Killerbee12/TFM-UPM/Prueba1/prueba_v1.0.runs/impl_1/.init_design.begin.rst

<?xml version="1.0"?>
<ProcessHandle Version="1" Minor="0">
    <Process Command=".planAhead." Owner="kille" Host="PC-DE-POCHECHE" Pid="14240">
    </Process>
</ProcessHandle>
