Killerbee12/TFM-UPM/Practica/Prueba1_demo_v2.1.1/Prueba1_demo_v2.1.1.runs/design_1_util_vector_logic_1_0_synth_1/.vivado.begin.rst

<?xml version="1.0"?>
<ProcessHandle Version="1" Minor="0">
    <Process Command="vivado.bat" Owner="kille" Host="SAMSUNG_BOOK_3" Pid="15120" HostCore="12" HostMemory="08257945600">
    </Process>
</ProcessHandle>
