Killerbee12/TFM-UPM/Practica/Prueba1_demo_v2.1.1/Prueba1_demo_v2.1.1.runs/impl_1/.place_design.begin.rst

<?xml version="1.0"?>
<ProcessHandle Version="1" Minor="0">
    <Process Command=".planAhead." Owner="kille" Host="SAMSUNG_BOOK_3" Pid="23184">
    </Process>
</ProcessHandle>
