Killerbee12/TFM-UPM/Practica/Prueba1/prueba_v1.0.runs/design_1_top_system_0_1_synth_1/.vivado.begin.rst

<?xml version="1.0"?>
<ProcessHandle Version="1" Minor="0">
    <Process Command="vivado.bat" Owner="kille" Host="SAMSUNG_BOOK_3" Pid="19268" HostCore="12" HostMemory="08257945600">
    </Process>
</ProcessHandle>
