Killerbee12/TFM-UPM/Documentacion/Prototipo de Sonido y LEDs- V1.pptx

## LED & audio prototype - V1

HW and FW Definitions
FEB 2026

OSA Electronics Co., Ltd.

## Slide 2

Definición del Hardware V1

- MCU SILICON LABS SIWG917Y – WIFI 6 + BLE 5.4 – 8MB INTERNAL FLASH
- SPEAKER AMPLIFIER TAS2110 6.1W I2S
- DIGITAL MEMS MICROPHONE
- RGB LED RING WURTH ELEKTRONIK WL-ICLED
- 2X 18650 BATTERIES + BMS

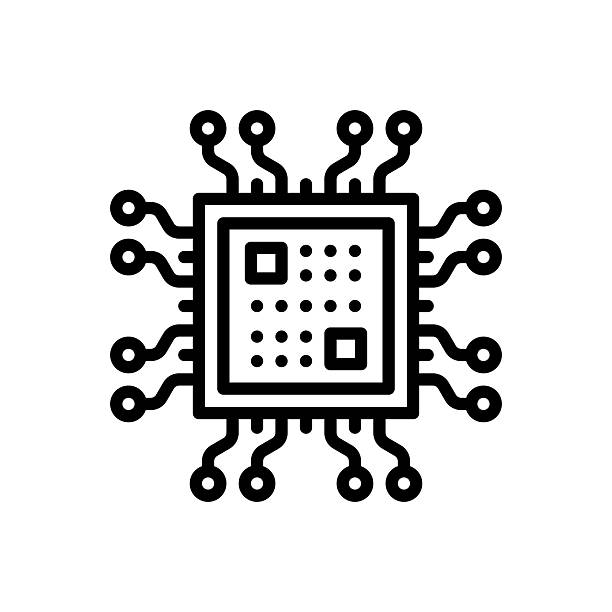
[picture p1: figure]

## Slide 3

Definición del Hardware V1

## Slide 4

Resources

- https://github.com/SiliconLabs/wiseconnect/tree/master/examples/si91x_soc/siwx917_dev_kit
- https://www.we-online.com/en/components/products/WL-ICLED#/articles/WL_ICLED_CHIP_LED_2020
- TAS (https://www.ti.com/lit/ds/symlink/tas2110.pdf?ts=1766407887314) 2110 (https://www.ti.com/lit/ds/symlink/tas2110.pdf?ts=1766407887314)Datasheet (https://www.ti.com/lit/ds/symlink/tas2110.pdf?ts=1766407887314)
- Simplicity Studio (https://www.silabs.com/developers/simplicity-studio)
- Simplicity Connect App (formerly EFR Connect App) (https://www.silabs.com/developers/simplicity-connect-mobile-app?tab=downloads)
