Killerbee12/TFM-UPM/Documentacion/Sondas_osciloscopio_P6100 passive probes.pdf

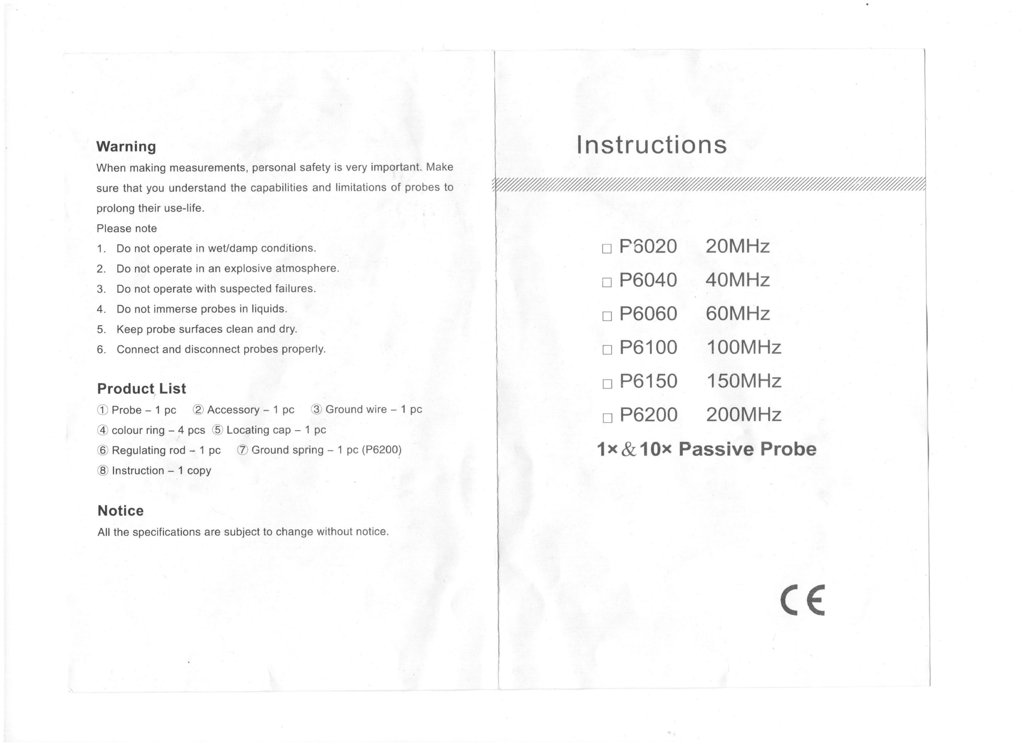
[picture p2: page 1]
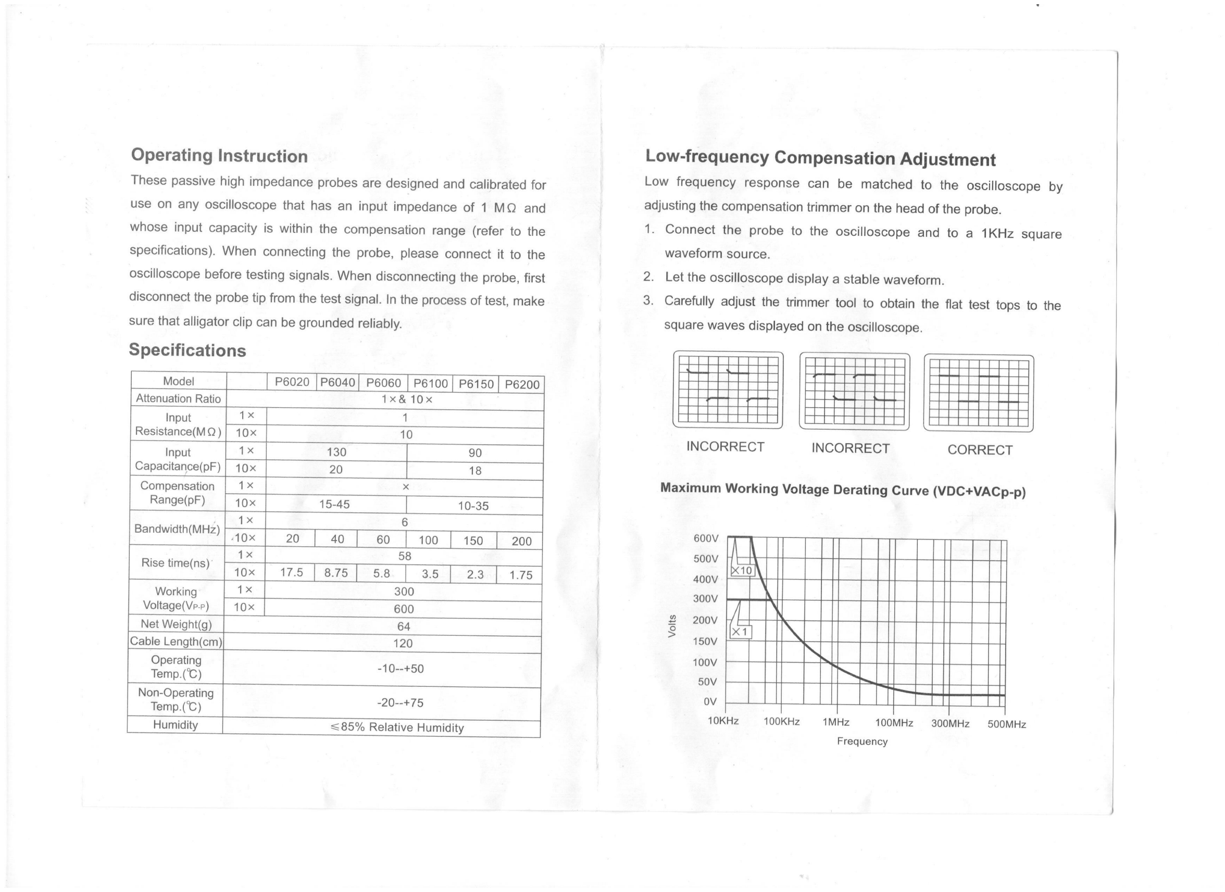
[picture p3: page 2]
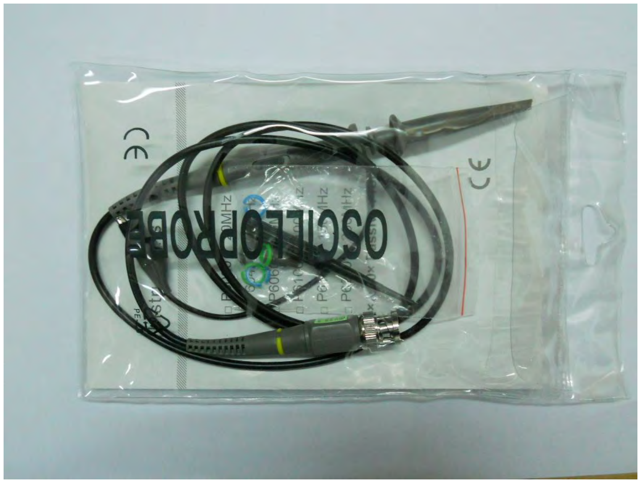
[picture p4: page 3]
