Killerbee12/TFM-UPM/Practica/Prueba1/prueba_v1.0.runs/impl_1/tight_setup_hold_pins.txt

+===============================+===============================+===================================================================================================================================================================================================================================================================================================================================================+
| Launch Setup Clock            | Launch Hold Clock             | Pin                                                                                                                                                                                                                                                                                                                                               |
+===============================+===============================+===================================================================================================================================================================================================================================================================================================================================================+
| clk_out1_design_1_clk_wiz_0_0 | clk_out1_design_1_clk_wiz_0_0 | design_1_i/top_system_0/U0/inst_audio_player/lrclk_prev_reg/D                                                                                                                                                                                                                                                                                     |
| clk_out1_design_1_clk_wiz_0_0 | clk_out1_design_1_clk_wiz_0_0 | design_1_i/blk_mem_gen_0/U0/inst_blk_mem_gen/gnbram.gnativebmg.native_blk_mem_gen/valid.cstr/ramloop[79].ram.r/prim_init.ram/design_1_i/blk_mem_gen_0/U0/inst_blk_mem_gen/gnbram.gnativebmg.native_blk_mem_gen/valid.cstr/ramloop[79].ram.r/prim_init.ram/DEVICE_7SERIES.NO_BMM_INFO.SP.CASCADED_PRIM36.ram_B_cooolgate_en_gate_14_cooolDelFlop/D |
| clk_out1_design_1_clk_wiz_0_0 | clk_out1_design_1_clk_wiz_0_0 | design_1_i/top_system_0/U0/inst_audio_player/addr_cnt_reg[11]/CE                                                                                                                                                                                                                                                                                  |
| clk_out1_design_1_clk_wiz_0_0 | clk_out1_design_1_clk_wiz_0_0 | design_1_i/top_system_0/U0/inst_audio_player/addr_cnt_reg[11]_replica_7/CE                                                                                                                                                                                                                                                                        |
| clk_out1_design_1_clk_wiz_0_0 | clk_out1_design_1_clk_wiz_0_0 | design_1_i/top_system_0/U0/inst_audio_player/addr_cnt_reg[10]_replica_5/CE                                                                                                                                                                                                                                                                        |
| clk_out1_design_1_clk_wiz_0_0 | clk_out1_design_1_clk_wiz_0_0 | design_1_i/top_system_0/U0/inst_audio_player/addr_cnt_reg[10]/CE                                                                                                                                                                                                                                                                                  |
| clk_out1_design_1_clk_wiz_0_0 | clk_out1_design_1_clk_wiz_0_0 | design_1_i/top_system_0/U0/inst_audio_player/addr_cnt_reg[11]_replica_2/CE                                                                                                                                                                                                                                                                        |
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
| clk_out1_design_1_clk_wiz_0_0 | clk_out1_design_1_clk_wiz_0_0 | design_1_i/system_ila_1/U0/ila_lib/U0/ila_core_inst/u_trig/U_TM/N_DDR_MODE.G_NMU[3].U_M/allx_typeA_match_detection.ltlib_v1_0_3_allx_typeA_inst/probeDelay1_reg[0]/D                                                                                                                                                                              |
+-------------------------------+-------------------------------+---------------------------------------------------------------------------------------------------------------------------------------------------------------------------------------------------------------------------------------------------------------------------------------------------------------------------------------------------+
