Killerbee12/TFM-UPM/Prueba1/prueba_v1.0.runs/impl_1/.vivado.begin.rst

<?xml version="1.0"?>
<ProcessHandle Version="1" Minor="0">
    <Process Command="vivado.bat" Owner="kille" Host="PC-DE-POCHECHE" Pid="13600" HostCore="4" HostMemory="017041461248">
    </Process>
</ProcessHandle>
<?xml version="1.0"?>
<ProcessHandle Version="1" Minor="0">
    <Process Command="vivado.bat" Owner="kille" Host="PC-DE-POCHECHE" Pid="14152" HostCore="4" HostMemory="017041461248">
    </Process>
</ProcessHandle>
<?xml version="1.0"?>
<ProcessHandle Version="1" Minor="0">
    <Process Command="vivado.bat" Owner="kille" Host="PC-DE-POCHECHE" Pid="13316" HostCore="4" HostMemory="017041461248">
    </Process>
</ProcessHandle>
<?xml version="1.0"?>
<ProcessHandle Version="1" Minor="0">
    <Process Command="vivado.bat" Owner="kille" Host="PC-DE-POCHECHE" Pid="14308" HostCore="4" HostMemory="017041461248">
    </Process>
</ProcessHandle>
<?xml version="1.0"?>
<ProcessHandle Version="1" Minor="0">
    <Process Command="vivado.bat" Owner="kille" Host="PC-DE-POCHECHE" Pid="14112" HostCore="4" HostMemory="017041461248">
    </Process>
</ProcessHandle>
