Killerbee12/TFM-UPM/Prueba1/prueba_v1.0.runs/synth_1/.vivado.begin.rst

<?xml version="1.0"?>
<ProcessHandle Version="1" Minor="0">
    <Process Command="vivado.bat" Owner="kille" Host="PC-DE-POCHECHE" Pid="14224" HostCore="4" HostMemory="017041461248">
    </Process>
</ProcessHandle>
