Killerbee12/TFM-UPM/Practica/Prueba1_demo_v2.1.1/Prueba1_demo_v2.1.1.runs/impl_1/.vivado.begin.rst

<?xml version="1.0"?>
<ProcessHandle Version="1" Minor="0">
    <Process Command="vivado.bat" Owner="kille" Host="SAMSUNG_BOOK_3" Pid="10956" HostCore="12" HostMemory="08257945600">
    </Process>
</ProcessHandle>
<?xml version="1.0"?>
<ProcessHandle Version="1" Minor="0">
    <Process Command="vivado.bat" Owner="kille" Host="SAMSUNG_BOOK_3" Pid="20960" HostCore="12" HostMemory="08257945600">
    </Process>
</ProcessHandle>
