Killerbee12/TFM-UPM/Practica/Prueba1_demo_v2.1.1/Prueba1_demo_v2.1.1.runs/impl_1/clockInfo.txt

-------------------------------------
| Tool Version : Vivado v.2025.1
| Date         : Wed Nov 11 23:36:08 2026
| Host         : Samsung_Book_3
| Design       : design_1
| Device       : xc7a100t-csg324-1--
-------------------------------------

For more information on clockInfo.txt clock routing debug file see https://support.xilinx.com/s/article/000035660?language=en_US
