Killerbee12/TFM-UPM/Practica/Prueba1/.Xil/Vivado-24480-Samsung_Book_3/hw_ila_data_1/zip_work/waveform.csv

Sample in Buffer | Sample in Window | TRIGGER | design_1_i/system_ila_0/U0/probe0[0:0]
Radix - UNSIGNED | UNSIGNED | UNSIGNED | HEX
0 | 0 | 0 | 0
1 | 1 | 0 | 0
2 | 2 | 0 | 0
3 | 3 | 0 | 0
4 | 4 | 0 | 0
5 | 5 | 0 | 0
6 | 6 | 0 | 0
7 | 7 | 0 | 0
8 | 8 | 0 | 0
9 | 9 | 0 | 0
10 | 10 | 0 | 0
11 | 11 | 0 | 0
12 | 12 | 0 | 0
13 | 13 | 0 | 0
14 | 14 | 0 | 0
15 | 15 | 0 | 0
16 | 16 | 0 | 0
17 | 17 | 0 | 0
18 | 18 | 0 | 0
19 | 19 | 0 | 0
20 | 20 | 0 | 0
21 | 21 | 0 | 0
22 | 22 | 0 | 0
23 | 23 | 0 | 0
24 | 24 | 0 | 0
25 | 25 | 0 | 0
26 | 26 | 0 | 0
27 | 27 | 0 | 0
28 | 28 | 0 | 0
29 | 29 | 0 | 0
30 | 30 | 0 | 0
31 | 31 | 0 | 0
32 | 32 | 0 | 0
33 | 33 | 0 | 0
34 | 34 | 0 | 0
35 | 35 | 0 | 0
36 | 36 | 0 | 0
37 | 37 | 0 | 0
38 | 38 | 0 | 0
39 | 39 | 0 | 0
40 | 40 | 0 | 0
41 | 41 | 0 | 0
42 | 42 | 0 | 0
43 | 43 | 0 | 0
44 | 44 | 0 | 0
45 | 45 | 0 | 0
46 | 46 | 0 | 0
47 | 47 | 0 | 0
48 | 48 | 0 | 0
49 | 49 | 0 | 0
50 | 50 | 0 | 0
51 | 51 | 0 | 0
52 | 52 | 0 | 0
53 | 53 | 0 | 0
54 | 54 | 0 | 0
55 | 55 | 0 | 0
56 | 56 | 0 | 0
57 | 57 | 0 | 0
58 | 58 | 0 | 0
59 | 59 | 0 | 0
60 | 60 | 0 | 0
61 | 61 | 0 | 0
62 | 62 | 0 | 0
63 | 63 | 0 | 0
64 | 64 | 0 | 0
65 | 65 | 0 | 0
66 | 66 | 0 | 0
67 | 67 | 0 | 0
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
