Killerbee12/TFM-UPM/Practica/Prueba1_demo_v2.1/.Xil/Vivado-17636-Samsung_Book_3/hw_ila_data_2/zip_work/waveform.csv

Sample in Buffer | Sample in Window | TRIGGER | design_1_i/system_ila_1/U0/probe0[0:0] | design_1_i/system_ila_1/U0/probe1[0:0] | design_1_i/system_ila_1/U0/probe2[0:0] | design_1_i/system_ila_1/U0/probe3[0:0] | design_1_i/system_ila_1/U0/probe4[0:0]
Radix - UNSIGNED | UNSIGNED | UNSIGNED | HEX | HEX | HEX | HEX | HEX
0 | 0 | 0 | 1 | 1 | 0 | 0 | 0
1 | 1 | 0 | 1 | 1 | 0 | 0 | 0
2 | 2 | 0 | 1 | 1 | 0 | 0 | 0
3 | 3 | 0 | 1 | 1 | 0 | 0 | 0
4 | 4 | 0 | 1 | 1 | 0 | 0 | 0
5 | 5 | 0 | 1 | 1 | 0 | 0 | 0
6 | 6 | 0 | 1 | 1 | 0 | 0 | 0
7 | 7 | 0 | 1 | 1 | 0 | 0 | 0
8 | 8 | 0 | 1 | 1 | 0 | 0 | 0
9 | 9 | 0 | 1 | 1 | 0 | 0 | 0
10 | 10 | 0 | 1 | 1 | 0 | 0 | 0
11 | 11 | 0 | 1 | 1 | 0 | 0 | 0
12 | 12 | 0 | 1 | 1 | 0 | 0 | 0
13 | 13 | 0 | 1 | 1 | 0 | 0 | 0
14 | 14 | 0 | 1 | 1 | 0 | 0 | 0
15 | 15 | 0 | 1 | 1 | 0 | 0 | 0
16 | 16 | 0 | 1 | 1 | 0 | 0 | 0
17 | 17 | 0 | 1 | 1 | 0 | 0 | 0
18 | 18 | 0 | 1 | 1 | 0 | 0 | 0
19 | 19 | 0 | 1 | 1 | 0 | 0 | 0
20 | 20 | 0 | 1 | 1 | 0 | 0 | 0
21 | 21 | 0 | 1 | 1 | 0 | 0 | 0
22 | 22 | 0 | 1 | 1 | 0 | 0 | 0
23 | 23 | 0 | 1 | 1 | 0 | 0 | 0
24 | 24 | 0 | 1 | 1 | 0 | 0 | 0
25 | 25 | 0 | 1 | 1 | 0 | 0 | 0
26 | 26 | 0 | 1 | 1 | 0 | 0 | 0
27 | 27 | 0 | 1 | 1 | 0 | 0 | 0
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
