Killerbee12/TFM-UPM/Capturas-Osciloscopio/Prueba_1_I2C/prueba_400khz_drenador_abierto.bmp

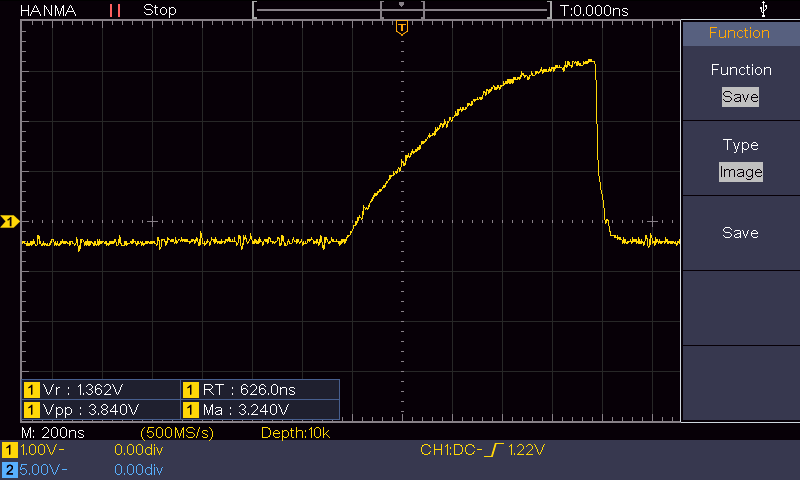
Capturas-Osciloscopio/Prueba_1_I2C/prueba_400khz_drenador_abierto.bmp
