Killerbee12/TFM-UPM/Capturas-Osciloscopio/Prueba_1_I2C/prueba_400khz_push_pull.bmp

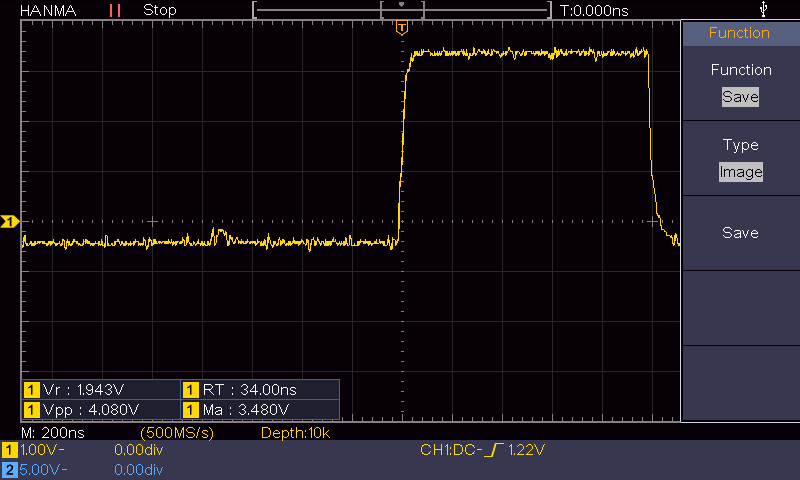
Capturas-Osciloscopio/Prueba_1_I2C/prueba_400khz_push_pull.bmp
