Killerbee12/TFM-UPM/Capturas-Osciloscopio/Prueba_1_I2C/secuencia_completa.bmp

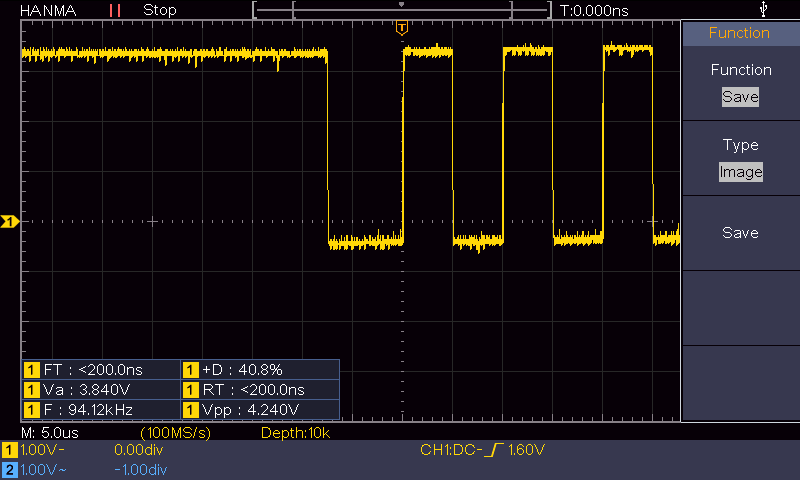
Capturas-Osciloscopio/Prueba_1_I2C/secuencia_completa.bmp
