Killerbee12/TFM-UPM/Capturas-Osciloscopio/Prueba_2_EtapaPotencia/bmp_26_006.bmp

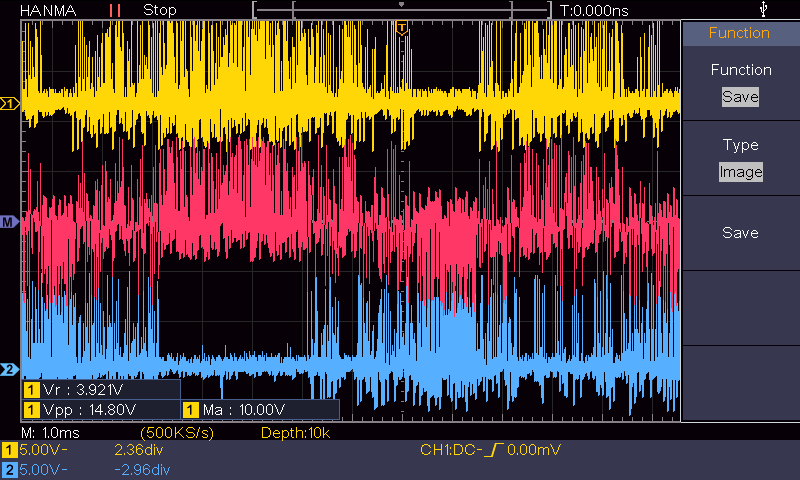
Capturas-Osciloscopio/Prueba_2_EtapaPotencia/bmp_26_006.bmp
