Killerbee12/TFM-UPM/Capturas-Osciloscopio/Prueba_2_EtapaPotencia/bmp_29_001.bmp

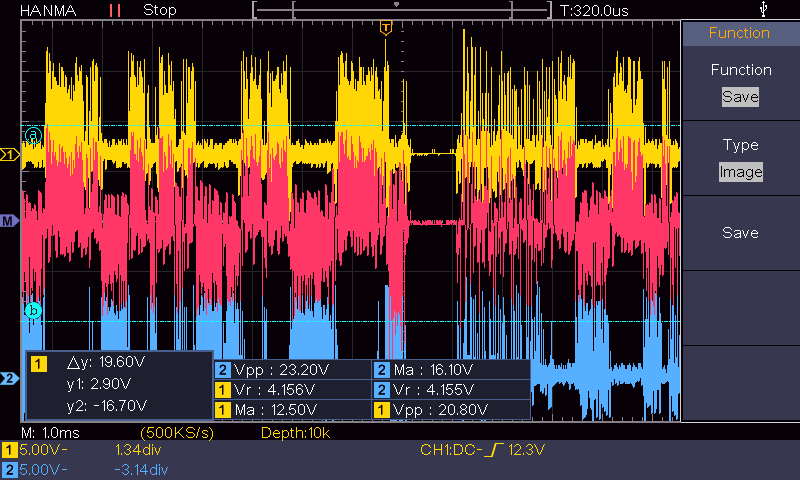
Capturas-Osciloscopio/Prueba_2_EtapaPotencia/bmp_29_001.bmp
