Killerbee12/TFM-UPM/Capturas-Osciloscopio/Prueba_2_EtapaPotencia/Con_limitador/A_01h_3_76Vpk.bmp

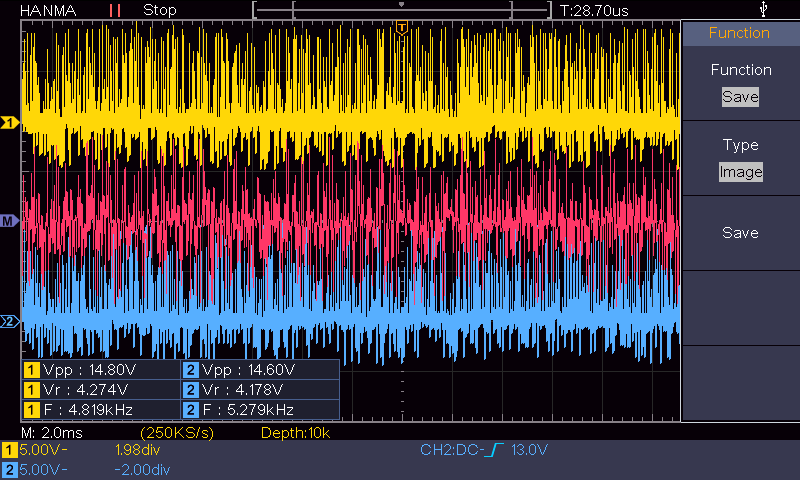
Capturas-Osciloscopio/Prueba_2_EtapaPotencia/Con_limitador/A_01h_3_76Vpk.bmp
