Killerbee12/TFM-UPM/Capturas-Osciloscopio/Prueba_2_EtapaPotencia/Con_limitador/bmp_32_011.bmp

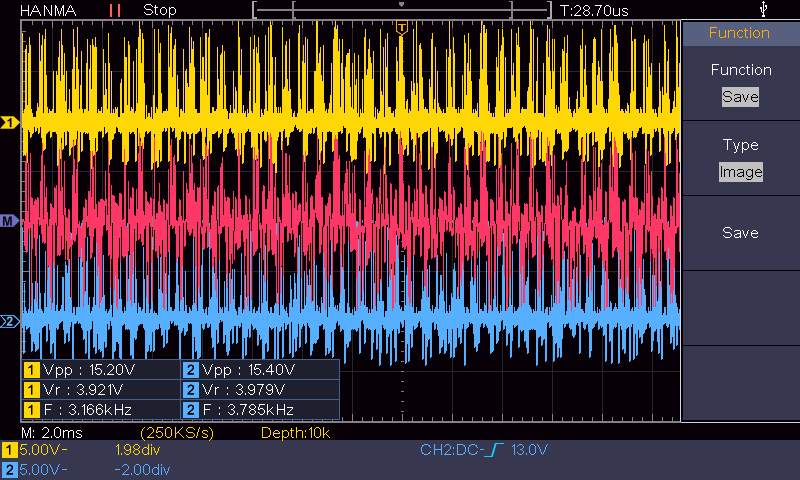
Capturas-Osciloscopio/Prueba_2_EtapaPotencia/Con_limitador/bmp_32_011.bmp
