Killerbee12/TFM-UPM/Capturas-Osciloscopio/Prueba_2_EtapaPotencia/Con_limitador/D_0Fh_8_43Vpk_1.bmp

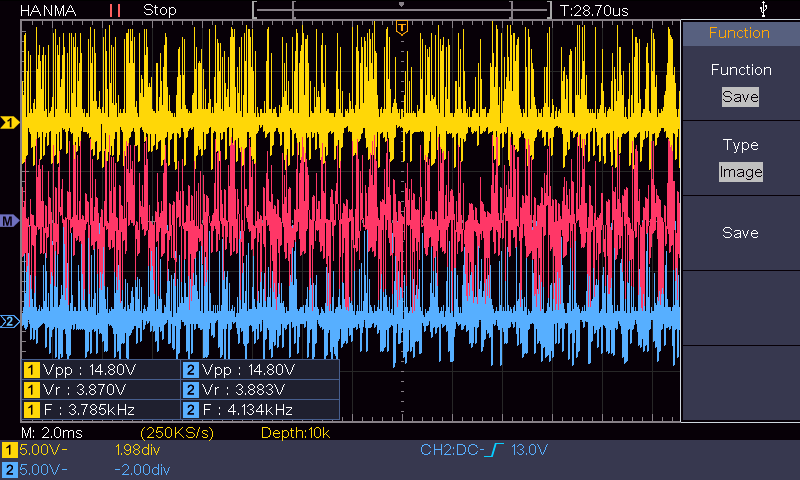
Capturas-Osciloscopio/Prueba_2_EtapaPotencia/Con_limitador/D_0Fh_8_43Vpk_1.bmp
