Killerbee12/TFM-UPM/Capturas-Osciloscopio/Prueba_2_EtapaPotencia/Con_limitador/E_14h_11_23Vpk_1.bmp

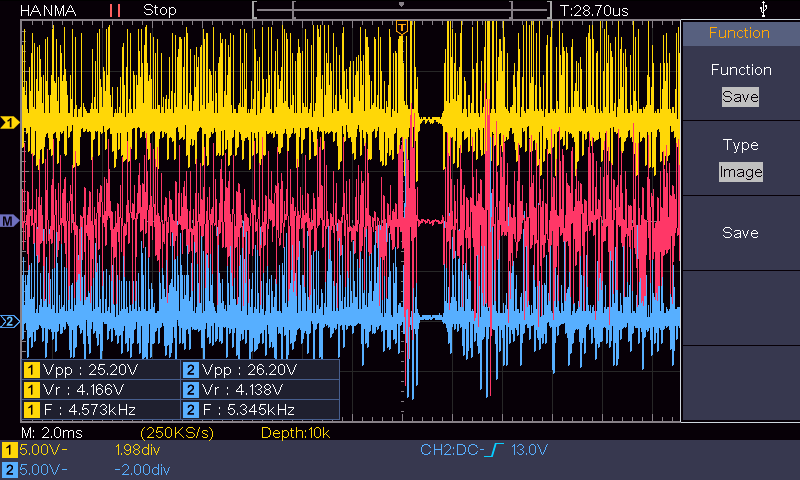
Capturas-Osciloscopio/Prueba_2_EtapaPotencia/Con_limitador/E_14h_11_23Vpk_1.bmp
