Killerbee12/TFM-UPM/Capturas-Osciloscopio/Prueba_2_EtapaPotencia/Sin_limitador/B_05h_4_74Vpk.bmp

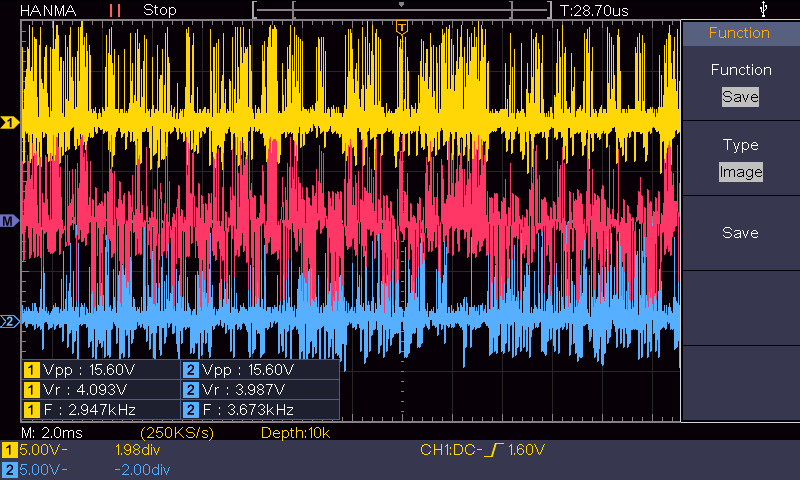
Capturas-Osciloscopio/Prueba_2_EtapaPotencia/Sin_limitador/B_05h_4_74Vpk.bmp
