Killerbee12/TFM-UPM/Capturas-Osciloscopio/Prueba_2_EtapaPotencia/Sin_limitador/bmp_32_005.bmp

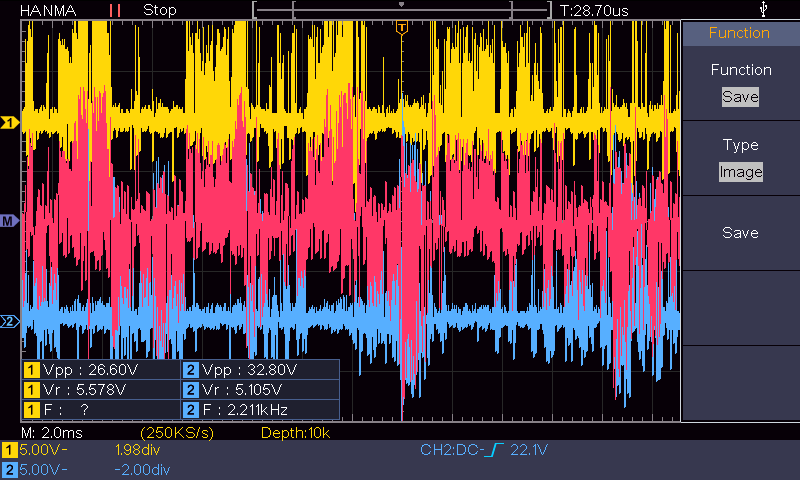
Capturas-Osciloscopio/Prueba_2_EtapaPotencia/Sin_limitador/bmp_32_005.bmp
