Killerbee12/TFM-UPM/Capturas-Osciloscopio/Prueba_2_EtapaPotencia/Sin_limitador/C_0Ah_6_32Vpk.bmp

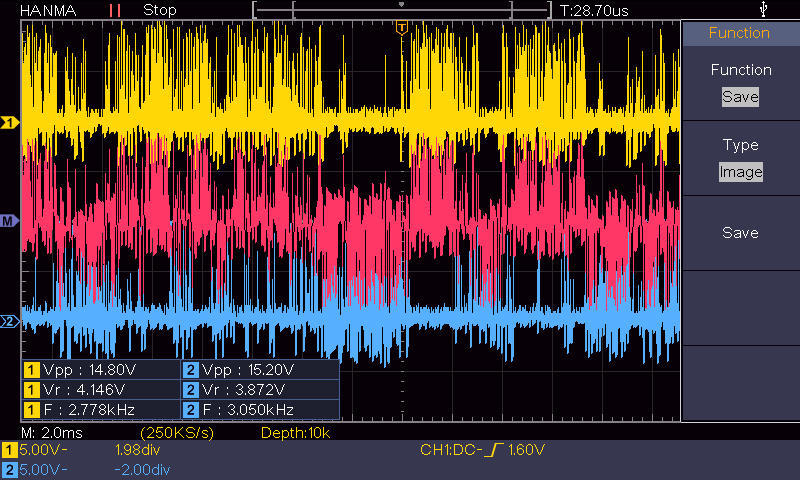
Capturas-Osciloscopio/Prueba_2_EtapaPotencia/Sin_limitador/C_0Ah_6_32Vpk.bmp
