Killerbee12/TFM-UPM/Capturas-Osciloscopio/Prueba_4_I2S_BCLK/bclk6.bmp

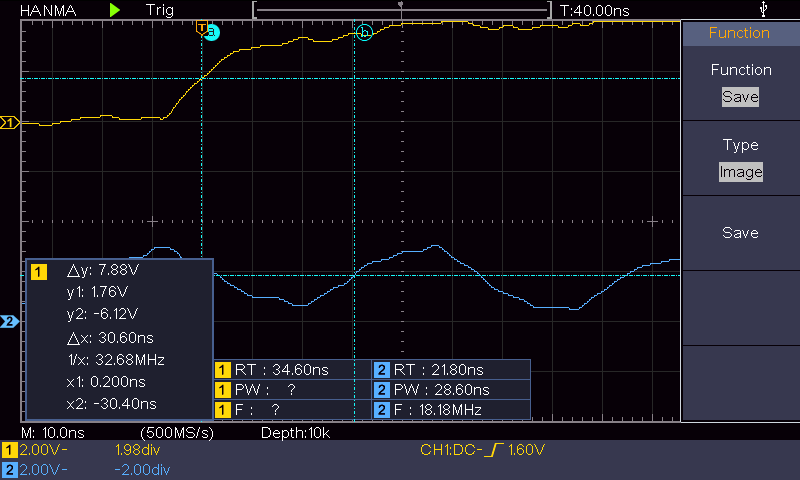
Capturas-Osciloscopio/Prueba_4_I2S_BCLK/bclk6.bmp
