Killerbee12/TFM-UPM/Documentacion/Esquematicos_Prototipo_FKR917XB_A0.pdf

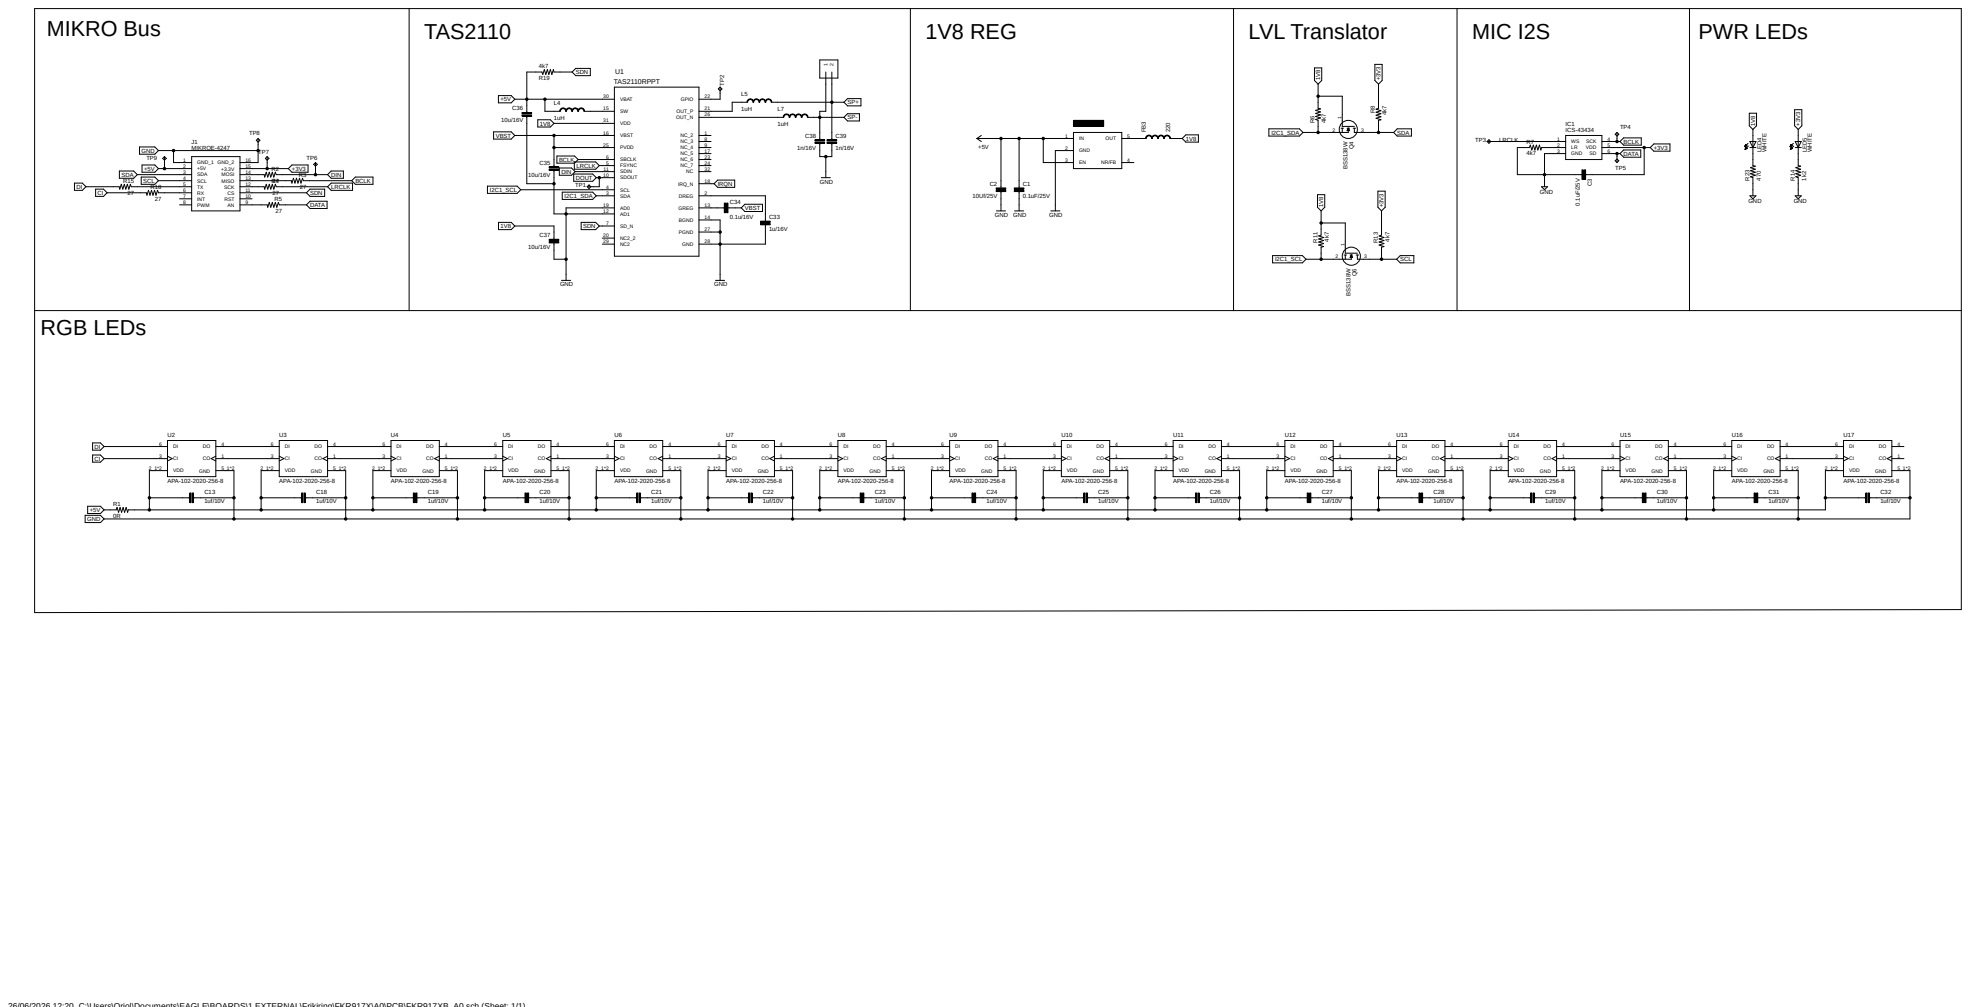
[picture p36: page 1]

26/06/2026 12:20 C:\Users\Oriol\Documents\EAGLE\BOARDS\1.EXTERNAL\Frikiring\FKR917X\A0\PCB\FKR917XB_A0.sch (Sheet: 1/1)
