Killerbee12/TFM-UPM/Practica/Prueba1/prueba_v1.0.runs/synth_1/.Xil/design_1_wrapper_propImpl.xdc

set_property SRC_FILE_INFO {cfile:C:/Users/kille/Documents/GitHub/TFM-UPM/Practica/Prueba1/prueba_v1.0.srcs/constrs_1/new/Nexys4DDR.xdc rfile:../../../prueba_v1.0.srcs/constrs_1/new/Nexys4DDR.xdc id:1} [current_design]
set_property src_info {type:XDC file:1 line:7 export:INPUT save:INPUT read:READ} [current_design]
set_property -dict { PACKAGE_PIN E3    IOSTANDARD LVCMOS33 } [get_ports { clk_100Mhz_0 }]; #IO_L12P_T1_MRCC_35 Sch=clk100mhz
set_property src_info {type:XDC file:1 line:50 export:INPUT save:INPUT read:READ} [current_design]
set_property -dict { PACKAGE_PIN T10   IOSTANDARD LVCMOS33 } [get_ports { seg_out_0_0[0] }]; #IO_L24N_T3_A00_D16_14 Sch=ca
set_property src_info {type:XDC file:1 line:51 export:INPUT save:INPUT read:READ} [current_design]
set_property -dict { PACKAGE_PIN R10   IOSTANDARD LVCMOS33 } [get_ports { seg_out_0_0[1] }]; #IO_25_14 Sch=cb
set_property src_info {type:XDC file:1 line:52 export:INPUT save:INPUT read:READ} [current_design]
set_property -dict { PACKAGE_PIN K16   IOSTANDARD LVCMOS33 } [get_ports { seg_out_0_0[2] }]; #IO_25_15 Sch=cc
set_property src_info {type:XDC file:1 line:53 export:INPUT save:INPUT read:READ} [current_design]
set_property -dict { PACKAGE_PIN K13   IOSTANDARD LVCMOS33 } [get_ports { seg_out_0_0[3] }]; #IO_L17P_T2_A26_15 Sch=cd
set_property src_info {type:XDC file:1 line:54 export:INPUT save:INPUT read:READ} [current_design]
set_property -dict { PACKAGE_PIN P15   IOSTANDARD LVCMOS33 } [get_ports { seg_out_0_0[4] }]; #IO_L13P_T2_MRCC_14 Sch=ce
set_property src_info {type:XDC file:1 line:55 export:INPUT save:INPUT read:READ} [current_design]
set_property -dict { PACKAGE_PIN T11   IOSTANDARD LVCMOS33 } [get_ports { seg_out_0_0[5] }]; #IO_L19P_T3_A10_D26_14 Sch=cf
set_property src_info {type:XDC file:1 line:56 export:INPUT save:INPUT read:READ} [current_design]
set_property -dict { PACKAGE_PIN L18   IOSTANDARD LVCMOS33 } [get_ports { seg_out_0_0[6] }]; #IO_L4P_T0_D04_14 Sch=cg
set_property src_info {type:XDC file:1 line:57 export:INPUT save:INPUT read:READ} [current_design]
set_property -dict { PACKAGE_PIN H15   IOSTANDARD LVCMOS33 } [get_ports { seg_dp_0_0 }]; #IO_L19N_T3_A21_VREF_15 Sch=dp
set_property src_info {type:XDC file:1 line:59 export:INPUT save:INPUT read:READ} [current_design]
set_property -dict { PACKAGE_PIN J17   IOSTANDARD LVCMOS33 } [get_ports { seg_an_0_0[0] }]; #IO_L23P_T3_FOE_B_15 Sch=an[0]
set_property src_info {type:XDC file:1 line:60 export:INPUT save:INPUT read:READ} [current_design]
set_property -dict { PACKAGE_PIN J18   IOSTANDARD LVCMOS33 } [get_ports { seg_an_0_0[1] }]; #IO_L23N_T3_FWE_B_15 Sch=an[1]
set_property src_info {type:XDC file:1 line:61 export:INPUT save:INPUT read:READ} [current_design]
set_property -dict { PACKAGE_PIN T9    IOSTANDARD LVCMOS33 } [get_ports { seg_an_0_0[2] }]; #IO_L24P_T3_A01_D17_14 Sch=an[2]
set_property src_info {type:XDC file:1 line:62 export:INPUT save:INPUT read:READ} [current_design]
set_property -dict { PACKAGE_PIN J14   IOSTANDARD LVCMOS33 } [get_ports { seg_an_0_0[3] }]; #IO_L19P_T3_A22_15 Sch=an[3]
set_property src_info {type:XDC file:1 line:63 export:INPUT save:INPUT read:READ} [current_design]
set_property -dict { PACKAGE_PIN P14   IOSTANDARD LVCMOS33 } [get_ports { seg_an_0_0[4] }]; #IO_L8N_T1_D12_14 Sch=an[4]
set_property src_info {type:XDC file:1 line:64 export:INPUT save:INPUT read:READ} [current_design]
set_property -dict { PACKAGE_PIN T14   IOSTANDARD LVCMOS33 } [get_ports { seg_an_0_0[5] }]; #IO_L14P_T2_SRCC_14 Sch=an[5]
set_property src_info {type:XDC file:1 line:65 export:INPUT save:INPUT read:READ} [current_design]
set_property -dict { PACKAGE_PIN K2    IOSTANDARD LVCMOS33 } [get_ports { seg_an_0_0[6] }]; #IO_L23P_T3_35 Sch=an[6]
set_property src_info {type:XDC file:1 line:66 export:INPUT save:INPUT read:READ} [current_design]
set_property -dict { PACKAGE_PIN U13   IOSTANDARD LVCMOS33 } [get_ports { seg_an_0_0[7] }]; #IO_L23N_T3_A02_D18_14 Sch=an[7]
set_property src_info {type:XDC file:1 line:70 export:INPUT save:INPUT read:READ} [current_design]
set_property -dict { PACKAGE_PIN J15   IOSTANDARD LVCMOS33 } [get_ports { sw0_reset_0 }]; #IO_L24N_T3_RS0_15 Sch=sw[0]
set_property src_info {type:XDC file:1 line:71 export:INPUT save:INPUT read:READ} [current_design]
set_property -dict { PACKAGE_PIN C12   IOSTANDARD LVCMOS33 } [get_ports { reset_n_0 }]; #IO_L3P_T0_DQS_AD1P_15 Sch=cpu_resetn
set_property src_info {type:XDC file:1 line:72 export:INPUT save:INPUT read:READ} [current_design]
set_property -dict { PACKAGE_PIN N17   IOSTANDARD LVCMOS33 } [get_ports { btn_center_0_0 }]; #IO_L9P_T1_DQS_14 Sch=btnc
set_property src_info {type:XDC file:1 line:73 export:INPUT save:INPUT read:READ} [current_design]
set_property -dict { PACKAGE_PIN M18   IOSTANDARD LVCMOS33 } [get_ports { btn_up_0_0 }]; #IO_L4N_T0_D05_14 Sch=btnu
set_property src_info {type:XDC file:1 line:74 export:INPUT save:INPUT read:READ} [current_design]
set_property -dict { PACKAGE_PIN P17   IOSTANDARD LVCMOS33 } [get_ports { btn_left_0_0 }]; #IO_L12P_T1_MRCC_14 Sch=btnl
set_property src_info {type:XDC file:1 line:75 export:INPUT save:INPUT read:READ} [current_design]
set_property -dict { PACKAGE_PIN M17   IOSTANDARD LVCMOS33 } [get_ports { btn_right_0_0 }]; #IO_L10N_T1_D15_14 Sch=btnr
set_property src_info {type:XDC file:1 line:76 export:INPUT save:INPUT read:READ} [current_design]
set_property -dict { PACKAGE_PIN P18   IOSTANDARD LVCMOS33 } [get_ports { btn_down_0_0 }]; #IO_L9N_T1_DQS_D13_14 Sch=btnd
set_property src_info {type:XDC file:1 line:81 export:INPUT save:INPUT read:READ} [current_design]
set_property -dict { PACKAGE_PIN C17   IOSTANDARD LVCMOS33 } [get_ports { led_clk_0 }]; #IO_L20N_T3_A19_15 Sch=ja[1]
set_property src_info {type:XDC file:1 line:82 export:INPUT save:INPUT read:READ} [current_design]
set_property -dict { PACKAGE_PIN D18   IOSTANDARD LVCMOS33 } [get_ports { led_data_0 }]; #IO_L21N_T3_DQS_A18_15 Sch=ja[2]
set_property src_info {type:XDC file:1 line:91 export:INPUT save:INPUT read:READ} [current_design]
set_property -dict { PACKAGE_PIN D14   IOSTANDARD LVCMOS33 PULLUP true } [get_ports { i2c_scl_0 }]; #IO_L1P_T0_AD0P_15 Sch=jb[1]
set_property src_info {type:XDC file:1 line:92 export:INPUT save:INPUT read:READ} [current_design]
set_property -dict { PACKAGE_PIN F16   IOSTANDARD LVCMOS33 PULLUP true } [get_ports { i2c_sda_0 }]; #IO_L14N_T2_SRCC_15 Sch=jb[2]
set_property src_info {type:XDC file:1 line:93 export:INPUT save:INPUT read:READ} [current_design]
set_property -dict { PACKAGE_PIN G16   IOSTANDARD LVCMOS33 } [get_ports { i2s_bclk_0 }]; #IO_L13N_T2_MRCC_15 Sch=jb[3]
set_property src_info {type:XDC file:1 line:94 export:INPUT save:INPUT read:READ} [current_design]
set_property -dict { PACKAGE_PIN H14   IOSTANDARD LVCMOS33 } [get_ports { i2s_lrclk_0 }]; #IO_L15P_T2_DQS_15 Sch=jb[4]
set_property src_info {type:XDC file:1 line:95 export:INPUT save:INPUT read:READ} [current_design]
set_property -dict { PACKAGE_PIN E16   IOSTANDARD LVCMOS33 } [get_ports { i2s_dout_0 }]; #IO_L11N_T1_SRCC_15 Sch=jb[7]
