Killerbee12/TFM-UPM/Practica/Prueba1_demo_v2.1.1/Prueba1_demo_v2.1.1.ip_user_files/bd/design_1/ip/design_1_fifo_generator_0_0/design_1_fifo_generator_0_0_sim_netlist.v

// Copyright 1986-2022 Xilinx, Inc. All Rights Reserved.
// Copyright 2022-2025 Advanced Micro Devices, Inc. All Rights Reserved.
// --------------------------------------------------------------------------------
// Tool Version: Vivado v.2025.1 (win64) Build 6140274 Thu May 22 00:12:29 MDT 2025
// Date        : Wed Aug  5 18:31:42 2026
// Host        : Samsung_Book_3 running 64-bit major release  (build 9200)
// Command     : write_verilog -force -mode funcsim -rename_top design_1_fifo_generator_0_0 -prefix
//               design_1_fifo_generator_0_0_ design_1_fifo_generator_0_0_sim_netlist.v
// Design      : design_1_fifo_generator_0_0
// Purpose     : This verilog netlist is a functional simulation representation of the design and should not be modified
//               or synthesized. This netlist cannot be used for SDF annotated simulation.
// Device      : xc7a100tcsg324-1
// --------------------------------------------------------------------------------
`timescale 1 ps / 1 ps

(* CHECK_LICENSE_TYPE = "design_1_fifo_generator_0_0,fifo_generator_v13_2_13,{}" *) (* downgradeipidentifiedwarnings = "yes" *) (* x_core_info = "fifo_generator_v13_2_13,Vivado 2025.1" *) 
(* NotValidForBitStream *)
module design_1_fifo_generator_0_0
   (clk,
    srst,
    din,
    wr_en,
    rd_en,
    dout,
    full,
    empty,
    valid,
    prog_full);
  (* x_interface_info = "xilinx.com:signal:clock:1.0 core_clk CLK" *) (* x_interface_mode = "slave core_clk" *) (* x_interface_parameter = "XIL_INTERFACENAME core_clk, FREQ_HZ 100000000, FREQ_TOLERANCE_HZ 0, PHASE 0.0, INSERT_VIP 0" *) input clk;
  input srst;
  (* x_interface_info = "xilinx.com:interface:fifo_write:1.0 FIFO_WRITE WR_DATA" *) (* x_interface_mode = "slave FIFO_WRITE" *) input [7:0]din;
  (* x_interface_info = "xilinx.com:interface:fifo_write:1.0 FIFO_WRITE WR_EN" *) input wr_en;
  (* x_interface_info = "xilinx.com:interface:fifo_read:1.0 FIFO_READ RD_EN" *) (* x_interface_mode = "slave FIFO_READ" *) input rd_en;
  (* x_interface_info = "xilinx.com:interface:fifo_read:1.0 FIFO_READ RD_DATA" *) output [7:0]dout;
  (* x_interface_info = "xilinx.com:interface:fifo_write:1.0 FIFO_WRITE FULL" *) output full;
  (* x_interface_info = "xilinx.com:interface:fifo_read:1.0 FIFO_READ EMPTY" *) output empty;
  output valid;
  output prog_full;

  wire clk;
  wire [7:0]din;
  wire [7:0]dout;
  wire empty;
  wire full;
  wire prog_full;
  wire rd_en;
  wire srst;
  wire valid;
  wire wr_en;
  wire NLW_U0_almost_empty_UNCONNECTED;
  wire NLW_U0_almost_full_UNCONNECTED;
  wire NLW_U0_axi_ar_dbiterr_UNCONNECTED;
  wire NLW_U0_axi_ar_overflow_UNCONNECTED;
  wire NLW_U0_axi_ar_prog_empty_UNCONNECTED;
  wire NLW_U0_axi_ar_prog_full_UNCONNECTED;
  wire NLW_U0_axi_ar_sbiterr_UNCONNECTED;
  wire NLW_U0_axi_ar_underflow_UNCONNECTED;
  wire NLW_U0_axi_aw_dbiterr_UNCONNECTED;
  wire NLW_U0_axi_aw_overflow_UNCONNECTED;
  wire NLW_U0_axi_aw_prog_empty_UNCONNECTED;
  wire NLW_U0_axi_aw_prog_full_UNCONNECTED;
  wire NLW_U0_axi_aw_sbiterr_UNCONNECTED;
  wire NLW_U0_axi_aw_underflow_UNCONNECTED;
  wire NLW_U0_axi_b_dbiterr_UNCONNECTED;
  wire NLW_U0_axi_b_overflow_UNCONNECTED;
  wire NLW_U0_axi_b_prog_empty_UNCONNECTED;
  wire NLW_U0_axi_b_prog_full_UNCONNECTED;
  wire NLW_U0_axi_b_sbiterr_UNCONNECTED;
  wire NLW_U0_axi_b_underflow_UNCONNECTED;
  wire NLW_U0_axi_r_dbiterr_UNCONNECTED;
  wire NLW_U0_axi_r_overflow_UNCONNECTED;
  wire NLW_U0_axi_r_prog_empty_UNCONNECTED;
  wire NLW_U0_axi_r_prog_full_UNCONNECTED;
  wire NLW_U0_axi_r_sbiterr_UNCONNECTED;
  wire NLW_U0_axi_r_underflow_UNCONNECTED;
  wire NLW_U0_axi_w_dbiterr_UNCONNECTED;
  wire NLW_U0_axi_w_overflow_UNCONNECTED;
  wire NLW_U0_axi_w_prog_empty_UNCONNECTED;
  wire NLW_U0_axi_w_prog_full_UNCONNECTED;
  wire NLW_U0_axi_w_sbiterr_UNCONNECTED;
  wire NLW_U0_axi_w_underflow_UNCONNECTED;
  wire NLW_U0_axis_dbiterr_UNCONNECTED;
  wire NLW_U0_axis_overflow_UNCONNECTED;
  wire NLW_U0_axis_prog_empty_UNCONNECTED;
  wire NLW_U0_axis_prog_full_UNCONNECTED;
  wire NLW_U0_axis_sbiterr_UNCONNECTED;
  wire NLW_U0_axis_underflow_UNCONNECTED;
  wire NLW_U0_dbiterr_UNCONNECTED;
  wire NLW_U0_m_axi_arvalid_UNCONNECTED;
  wire NLW_U0_m_axi_awvalid_UNCONNECTED;
  wire NLW_U0_m_axi_bready_UNCONNECTED;
  wire NLW_U0_m_axi_rready_UNCONNECTED;
  wire NLW_U0_m_axi_wlast_UNCONNECTED;
  wire NLW_U0_m_axi_wvalid_UNCONNECTED;
  wire NLW_U0_m_axis_tlast_UNCONNECTED;
  wire NLW_U0_m_axis_tvalid_UNCONNECTED;
  wire NLW_U0_overflow_UNCONNECTED;
  wire NLW_U0_prog_empty_UNCONNECTED;
  wire NLW_U0_rd_rst_busy_UNCONNECTED;
  wire NLW_U0_s_axi_arready_UNCONNECTED;
  wire NLW_U0_s_axi_awready_UNCONNECTED;
  wire NLW_U0_s_axi_bvalid_UNCONNECTED;
  wire NLW_U0_s_axi_rlast_UNCONNECTED;
  wire NLW_U0_s_axi_rvalid_UNCONNECTED;
  wire NLW_U0_s_axi_wready_UNCONNECTED;
  wire NLW_U0_s_axis_tready_UNCONNECTED;
  wire NLW_U0_sbiterr_UNCONNECTED;
  wire NLW_U0_underflow_UNCONNECTED;
  wire NLW_U0_wr_ack_UNCONNECTED;
  wire NLW_U0_wr_rst_busy_UNCONNECTED;
  wire [4:0]NLW_U0_axi_ar_data_count_UNCONNECTED;
  wire [4:0]NLW_U0_axi_ar_rd_data_count_UNCONNECTED;
  wire [4:0]NLW_U0_axi_ar_wr_data_count_UNCONNECTED;
  wire [4:0]NLW_U0_axi_aw_data_count_UNCONNECTED;
  wire [4:0]NLW_U0_axi_aw_rd_data_count_UNCONNECTED;
  wire [4:0]NLW_U0_axi_aw_wr_data_count_UNCONNECTED;
  wire [4:0]NLW_U0_axi_b_data_count_UNCONNECTED;
  wire [4:0]NLW_U0_axi_b_rd_data_count_UNCONNECTED;
  wire [4:0]NLW_U0_axi_b_wr_data_count_UNCONNECTED;
  wire [10:0]NLW_U0_axi_r_data_count_UNCONNECTED;
  wire [10:0]NLW_U0_axi_r_rd_data_count_UNCONNECTED;
  wire [10:0]NLW_U0_axi_r_wr_data_count_UNCONNECTED;
  wire [10:0]NLW_U0_axi_w_data_count_UNCONNECTED;
  wire [10:0]NLW_U0_axi_w_rd_data_count_UNCONNECTED;
  wire [10:0]NLW_U0_axi_w_wr_data_count_UNCONNECTED;
  wire [10:0]NLW_U0_axis_data_count_UNCONNECTED;
  wire [10:0]NLW_U0_axis_rd_data_count_UNCONNECTED;
  wire [10:0]NLW_U0_axis_wr_data_count_UNCONNECTED;
  wire [10:0]NLW_U0_data_count_UNCONNECTED;
  wire [31:0]NLW_U0_m_axi_araddr_UNCONNECTED;
  wire [1:0]NLW_U0_m_axi_arburst_UNCONNECTED;
  wire [3:0]NLW_U0_m_axi_arcache_UNCONNECTED;
  wire [0:0]NLW_U0_m_axi_arid_UNCONNECTED;
  wire [7:0]NLW_U0_m_axi_arlen_UNCONNECTED;
  wire [0:0]NLW_U0_m_axi_arlock_UNCONNECTED;
  wire [2:0]NLW_U0_m_axi_arprot_UNCONNECTED;
  wire [3:0]NLW_U0_m_axi_arqos_UNCONNECTED;
  wire [3:0]NLW_U0_m_axi_arregion_UNCONNECTED;
  wire [2:0]NLW_U0_m_axi_arsize_UNCONNECTED;
  wire [0:0]NLW_U0_m_axi_aruser_UNCONNECTED;
  wire [31:0]NLW_U0_m_axi_awaddr_UNCONNECTED;
  wire [1:0]NLW_U0_m_axi_awburst_UNCONNECTED;
  wire [3:0]NLW_U0_m_axi_awcache_UNCONNECTED;
  wire [0:0]NLW_U0_m_axi_awid_UNCONNECTED;
  wire [7:0]NLW_U0_m_axi_awlen_UNCONNECTED;
  wire [0:0]NLW_U0_m_axi_awlock_UNCONNECTED;
  wire [2:0]NLW_U0_m_axi_awprot_UNCONNECTED;
  wire [3:0]NLW_U0_m_axi_awqos_UNCONNECTED;
  wire [3:0]NLW_U0_m_axi_awregion_UNCONNECTED;
  wire [2:0]NLW_U0_m_axi_awsize_UNCONNECTED;
  wire [0:0]NLW_U0_m_axi_awuser_UNCONNECTED;
  wire [63:0]NLW_U0_m_axi_wdata_UNCONNECTED;
  wire [0:0]NLW_U0_m_axi_wid_UNCONNECTED;
  wire [7:0]NLW_U0_m_axi_wstrb_UNCONNECTED;
  wire [0:0]NLW_U0_m_axi_wuser_UNCONNECTED;
  wire [7:0]NLW_U0_m_axis_tdata_UNCONNECTED;
  wire [0:0]NLW_U0_m_axis_tdest_UNCONNECTED;
  wire [0:0]NLW_U0_m_axis_tid_UNCONNECTED;
  wire [0:0]NLW_U0_m_axis_tkeep_UNCONNECTED;
  wire [0:0]NLW_U0_m_axis_tstrb_UNCONNECTED;
  wire [3:0]NLW_U0_m_axis_tuser_UNCONNECTED;
  wire [10:0]NLW_U0_rd_data_count_UNCONNECTED;
  wire [0:0]NLW_U0_s_axi_bid_UNCONNECTED;
  wire [1:0]NLW_U0_s_axi_bresp_UNCONNECTED;
  wire [0:0]NLW_U0_s_axi_buser_UNCONNECTED;
  wire [63:0]NLW_U0_s_axi_rdata_UNCONNECTED;
  wire [0:0]NLW_U0_s_axi_rid_UNCONNECTED;
  wire [1:0]NLW_U0_s_axi_rresp_UNCONNECTED;
  wire [0:0]NLW_U0_s_axi_ruser_UNCONNECTED;
  wire [10:0]NLW_U0_wr_data_count_UNCONNECTED;

  (* C_ADD_NGC_CONSTRAINT = "0" *) 
  (* C_APPLICATION_TYPE_AXIS = "0" *) 
  (* C_APPLICATION_TYPE_RACH = "0" *) 
  (* C_APPLICATION_TYPE_RDCH = "0" *) 
  (* C_APPLICATION_TYPE_WACH = "0" *) 
  (* C_APPLICATION_TYPE_WDCH = "0" *) 
  (* C_APPLICATION_TYPE_WRCH = "0" *) 
  (* C_AXIS_TDATA_WIDTH = "8" *) 
  (* C_AXIS_TDEST_WIDTH = "1" *) 
  (* C_AXIS_TID_WIDTH = "1" *) 
  (* C_AXIS_TKEEP_WIDTH = "1" *) 
  (* C_AXIS_TSTRB_WIDTH = "1" *) 
  (* C_AXIS_TUSER_WIDTH = "4" *) 
  (* C_AXIS_TYPE = "0" *) 
  (* C_AXI_ADDR_WIDTH = "32" *) 
  (* C_AXI_ARUSER_WIDTH = "1" *) 
  (* C_AXI_AWUSER_WIDTH = "1" *) 
  (* C_AXI_BUSER_WIDTH = "1" *) 
  (* C_AXI_DATA_WIDTH = "64" *) 
  (* C_AXI_ID_WIDTH = "1" *) 
  (* C_AXI_LEN_WIDTH = "8" *) 
  (* C_AXI_LOCK_WIDTH = "1" *) 
  (* C_AXI_RUSER_WIDTH = "1" *) 
  (* C_AXI_TYPE = "1" *) 
  (* C_AXI_WUSER_WIDTH = "1" *) 
  (* C_COMMON_CLOCK = "1" *) 
  (* C_COUNT_TYPE = "0" *) 
  (* C_DATA_COUNT_WIDTH = "11" *) 
  (* C_DEFAULT_VALUE = "BlankString" *) 
  (* C_DIN_WIDTH = "8" *) 
  (* C_DIN_WIDTH_AXIS = "1" *) 
  (* C_DIN_WIDTH_RACH = "32" *) 
  (* C_DIN_WIDTH_RDCH = "64" *) 
  (* C_DIN_WIDTH_WACH = "1" *) 
  (* C_DIN_WIDTH_WDCH = "64" *) 
  (* C_DIN_WIDTH_WRCH = "2" *) 
  (* C_DOUT_RST_VAL = "0" *) 
  (* C_DOUT_WIDTH = "8" *) 
  (* C_ENABLE_RLOCS = "0" *) 
  (* C_ENABLE_RST_SYNC = "1" *) 
  (* C_EN_SAFETY_CKT = "0" *) 
  (* C_ERROR_INJECTION_TYPE = "0" *) 
  (* C_ERROR_INJECTION_TYPE_AXIS = "0" *) 
  (* C_ERROR_INJECTION_TYPE_RACH = "0" *) 
  (* C_ERROR_INJECTION_TYPE_RDCH = "0" *) 
  (* C_ERROR_INJECTION_TYPE_WACH = "0" *) 
  (* C_ERROR_INJECTION_TYPE_WDCH = "0" *) 
  (* C_ERROR_INJECTION_TYPE_WRCH = "0" *) 
  (* C_FAMILY = "artix7" *) 
  (* C_FULL_FLAGS_RST_VAL = "0" *) 
  (* C_HAS_ALMOST_EMPTY = "0" *) 
  (* C_HAS_ALMOST_FULL = "0" *) 
  (* C_HAS_AXIS_TDATA = "1" *) 
  (* C_HAS_AXIS_TDEST = "0" *) 
  (* C_HAS_AXIS_TID = "0" *) 
  (* C_HAS_AXIS_TKEEP = "0" *) 
  (* C_HAS_AXIS_TLAST = "0" *) 
  (* C_HAS_AXIS_TREADY = "1" *) 
  (* C_HAS_AXIS_TSTRB = "0" *) 
  (* C_HAS_AXIS_TUSER = "1" *) 
  (* C_HAS_AXI_ARUSER = "0" *) 
  (* C_HAS_AXI_AWUSER = "0" *) 
  (* C_HAS_AXI_BUSER = "0" *) 
  (* C_HAS_AXI_ID = "0" *) 
  (* C_HAS_AXI_RD_CHANNEL = "1" *) 
  (* C_HAS_AXI_RUSER = "0" *) 
  (* C_HAS_AXI_WR_CHANNEL = "1" *) 
  (* C_HAS_AXI_WUSER = "0" *) 
  (* C_HAS_BACKUP = "0" *) 
  (* C_HAS_DATA_COUNT = "0" *) 
  (* C_HAS_DATA_COUNTS_AXIS = "0" *) 
  (* C_HAS_DATA_COUNTS_RACH = "0" *) 
  (* C_HAS_DATA_COUNTS_RDCH = "0" *) 
  (* C_HAS_DATA_COUNTS_WACH = "0" *) 
  (* C_HAS_DATA_COUNTS_WDCH = "0" *) 
  (* C_HAS_DATA_COUNTS_WRCH = "0" *) 
  (* C_HAS_INT_CLK = "0" *) 
  (* C_HAS_MASTER_CE = "0" *) 
  (* C_HAS_MEMINIT_FILE = "0" *) 
  (* C_HAS_OVERFLOW = "0" *) 
  (* C_HAS_PROG_FLAGS_AXIS = "0" *) 
  (* C_HAS_PROG_FLAGS_RACH = "0" *) 
  (* C_HAS_PROG_FLAGS_RDCH = "0" *) 
  (* C_HAS_PROG_FLAGS_WACH = "0" *) 
  (* C_HAS_PROG_FLAGS_WDCH = "0" *) 
  (* C_HAS_PROG_FLAGS_WRCH = "0" *) 
  (* C_HAS_RD_DATA_COUNT = "0" *) 
  (* C_HAS_RD_RST = "0" *) 
  (* C_HAS_RST = "0" *) 
  (* C_HAS_SLAVE_CE = "0" *) 
  (* C_HAS_SRST = "1" *) 
  (* C_HAS_UNDERFLOW = "0" *) 
  (* C_HAS_VALID = "1" *) 
  (* C_HAS_WR_ACK = "0" *) 
  (* C_HAS_WR_DATA_COUNT = "0" *) 
  (* C_HAS_WR_RST = "0" *) 
  (* C_IMPLEMENTATION_TYPE = "0" *) 
  (* C_IMPLEMENTATION_TYPE_AXIS = "1" *) 
  (* C_IMPLEMENTATION_TYPE_RACH = "1" *) 
  (* C_IMPLEMENTATION_TYPE_RDCH = "1" *) 
  (* C_IMPLEMENTATION_TYPE_WACH = "1" *) 
  (* C_IMPLEMENTATION_TYPE_WDCH = "1" *) 
  (* C_IMPLEMENTATION_TYPE_WRCH = "1" *) 
  (* C_INIT_WR_PNTR_VAL = "0" *) 
  (* C_INTERFACE_TYPE = "0" *) 
  (* C_MEMORY_TYPE = "1" *) 
  (* C_MIF_FILE_NAME = "BlankString" *) 
  (* C_MSGON_VAL = "1" *) 
  (* C_OPTIMIZATION_MODE = "0" *) 
  (* C_OVERFLOW_LOW = "0" *) 
  (* C_POWER_SAVING_MODE = "0" *) 
  (* C_PRELOAD_LATENCY = "1" *) 
  (* C_PRELOAD_REGS = "0" *) 
  (* C_PRIM_FIFO_TYPE = "2kx9" *) 
  (* C_PRIM_FIFO_TYPE_AXIS = "1kx18" *) 
  (* C_PRIM_FIFO_TYPE_RACH = "512x36" *) 
  (* C_PRIM_FIFO_TYPE_RDCH = "1kx36" *) 
  (* C_PRIM_FIFO_TYPE_WACH = "512x36" *) 
  (* C_PRIM_FIFO_TYPE_WDCH = "1kx36" *) 
  (* C_PRIM_FIFO_TYPE_WRCH = "512x36" *) 
  (* C_PROG_EMPTY_THRESH_ASSERT_VAL = "2" *) 
  (* C_PROG_EMPTY_THRESH_ASSERT_VAL_AXIS = "1022" *) 
  (* C_PROG_EMPTY_THRESH_ASSERT_VAL_RACH = "1022" *) 
  (* C_PROG_EMPTY_THRESH_ASSERT_VAL_RDCH = "1022" *) 
  (* C_PROG_EMPTY_THRESH_ASSERT_VAL_WACH = "1022" *) 
  (* C_PROG_EMPTY_THRESH_ASSERT_VAL_WDCH = "1022" *) 
  (* C_PROG_EMPTY_THRESH_ASSERT_VAL_WRCH = "1022" *) 
  (* C_PROG_EMPTY_THRESH_NEGATE_VAL = "3" *) 
  (* C_PROG_EMPTY_TYPE = "0" *) 
  (* C_PROG_EMPTY_TYPE_AXIS = "0" *) 
  (* C_PROG_EMPTY_TYPE_RACH = "0" *) 
  (* C_PROG_EMPTY_TYPE_RDCH = "0" *) 
  (* C_PROG_EMPTY_TYPE_WACH = "0" *) 
  (* C_PROG_EMPTY_TYPE_WDCH = "0" *) 
  (* C_PROG_EMPTY_TYPE_WRCH = "0" *) 
  (* C_PROG_FULL_THRESH_ASSERT_VAL = "1500" *) 
  (* C_PROG_FULL_THRESH_ASSERT_VAL_AXIS = "1023" *) 
  (* C_PROG_FULL_THRESH_ASSERT_VAL_RACH = "1023" *) 
  (* C_PROG_FULL_THRESH_ASSERT_VAL_RDCH = "1023" *) 
  (* C_PROG_FULL_THRESH_ASSERT_VAL_WACH = "1023" *) 
  (* C_PROG_FULL_THRESH_ASSERT_VAL_WDCH = "1023" *) 
  (* C_PROG_FULL_THRESH_ASSERT_VAL_WRCH = "1023" *) 
  (* C_PROG_FULL_THRESH_NEGATE_VAL = "1499" *) 
  (* C_PROG_FULL_TYPE = "1" *) 
  (* C_PROG_FULL_TYPE_AXIS = "0" *) 
  (* C_PROG_FULL_TYPE_RACH = "0" *) 
  (* C_PROG_FULL_TYPE_RDCH = "0" *) 
  (* C_PROG_FULL_TYPE_WACH = "0" *) 
  (* C_PROG_FULL_TYPE_WDCH = "0" *) 
  (* C_PROG_FULL_TYPE_WRCH = "0" *) 
  (* C_RACH_TYPE = "0" *) 
  (* C_RDCH_TYPE = "0" *) 
  (* C_RD_DATA_COUNT_WIDTH = "11" *) 
  (* C_RD_DEPTH = "2048" *) 
  (* C_RD_FREQ = "1" *) 
  (* C_RD_PNTR_WIDTH = "11" *) 
  (* C_REG_SLICE_MODE_AXIS = "0" *) 
  (* C_REG_SLICE_MODE_RACH = "0" *) 
  (* C_REG_SLICE_MODE_RDCH = "0" *) 
  (* C_REG_SLICE_MODE_WACH = "0" *) 
  (* C_REG_SLICE_MODE_WDCH = "0" *) 
  (* C_REG_SLICE_MODE_WRCH = "0" *) 
  (* C_SELECT_XPM = "0" *) 
  (* C_SYNCHRONIZER_STAGE = "2" *) 
  (* C_UNDERFLOW_LOW = "0" *) 
  (* C_USE_COMMON_OVERFLOW = "0" *) 
  (* C_USE_COMMON_UNDERFLOW = "0" *) 
  (* C_USE_DEFAULT_SETTINGS = "0" *) 
  (* C_USE_DOUT_RST = "1" *) 
  (* C_USE_ECC = "0" *) 
  (* C_USE_ECC_AXIS = "0" *) 
  (* C_USE_ECC_RACH = "0" *) 
  (* C_USE_ECC_RDCH = "0" *) 
  (* C_USE_ECC_WACH = "0" *) 
  (* C_USE_ECC_WDCH = "0" *) 
  (* C_USE_ECC_WRCH = "0" *) 
  (* C_USE_EMBEDDED_REG = "0" *) 
  (* C_USE_FIFO16_FLAGS = "0" *) 
  (* C_USE_FWFT_DATA_COUNT = "0" *) 
  (* C_USE_PIPELINE_REG = "0" *) 
  (* C_VALID_LOW = "0" *) 
  (* C_WACH_TYPE = "0" *) 
  (* C_WDCH_TYPE = "0" *) 
  (* C_WRCH_TYPE = "0" *) 
  (* C_WR_ACK_LOW = "0" *) 
  (* C_WR_DATA_COUNT_WIDTH = "11" *) 
  (* C_WR_DEPTH = "2048" *) 
  (* C_WR_DEPTH_AXIS = "1024" *) 
  (* C_WR_DEPTH_RACH = "16" *) 
  (* C_WR_DEPTH_RDCH = "1024" *) 
  (* C_WR_DEPTH_WACH = "16" *) 
  (* C_WR_DEPTH_WDCH = "1024" *) 
  (* C_WR_DEPTH_WRCH = "16" *) 
  (* C_WR_FREQ = "1" *) 
  (* C_WR_PNTR_WIDTH = "11" *) 
  (* C_WR_PNTR_WIDTH_AXIS = "10" *) 
  (* C_WR_PNTR_WIDTH_RACH = "4" *) 
  (* C_WR_PNTR_WIDTH_RDCH = "10" *) 
  (* C_WR_PNTR_WIDTH_WACH = "4" *) 
  (* C_WR_PNTR_WIDTH_WDCH = "10" *) 
  (* C_WR_PNTR_WIDTH_WRCH = "4" *) 
  (* C_WR_RESPONSE_LATENCY = "1" *) 
  (* is_du_within_envelope = "true" *) 
  design_1_fifo_generator_0_0_fifo_generator_v13_2_13 U0
       (.almost_empty(NLW_U0_almost_empty_UNCONNECTED),
        .almost_full(NLW_U0_almost_full_UNCONNECTED),
        .axi_ar_data_count(NLW_U0_axi_ar_data_count_UNCONNECTED[4:0]),
        .axi_ar_dbiterr(NLW_U0_axi_ar_dbiterr_UNCONNECTED),
        .axi_ar_injectdbiterr(1'b0),
        .axi_ar_injectsbiterr(1'b0),
        .axi_ar_overflow(NLW_U0_axi_ar_overflow_UNCONNECTED),
        .axi_ar_prog_empty(NLW_U0_axi_ar_prog_empty_UNCONNECTED),
        .axi_ar_prog_empty_thresh({1'b0,1'b0,1'b0,1'b0}),
        .axi_ar_prog_full(NLW_U0_axi_ar_prog_full_UNCONNECTED),
        .axi_ar_prog_full_thresh({1'b0,1'b0,1'b0,1'b0}),
        .axi_ar_rd_data_count(NLW_U0_axi_ar_rd_data_count_UNCONNECTED[4:0]),
        .axi_ar_sbiterr(NLW_U0_axi_ar_sbiterr_UNCONNECTED),
        .axi_ar_underflow(NLW_U0_axi_ar_underflow_UNCONNECTED),
        .axi_ar_wr_data_count(NLW_U0_axi_ar_wr_data_count_UNCONNECTED[4:0]),
        .axi_aw_data_count(NLW_U0_axi_aw_data_count_UNCONNECTED[4:0]),
        .axi_aw_dbiterr(NLW_U0_axi_aw_dbiterr_UNCONNECTED),
        .axi_aw_injectdbiterr(1'b0),
        .axi_aw_injectsbiterr(1'b0),
        .axi_aw_overflow(NLW_U0_axi_aw_overflow_UNCONNECTED),
        .axi_aw_prog_empty(NLW_U0_axi_aw_prog_empty_UNCONNECTED),
        .axi_aw_prog_empty_thresh({1'b0,1'b0,1'b0,1'b0}),
        .axi_aw_prog_full(NLW_U0_axi_aw_prog_full_UNCONNECTED),
        .axi_aw_prog_full_thresh({1'b0,1'b0,1'b0,1'b0}),
        .axi_aw_rd_data_count(NLW_U0_axi_aw_rd_data_count_UNCONNECTED[4:0]),
        .axi_aw_sbiterr(NLW_U0_axi_aw_sbiterr_UNCONNECTED),
        .axi_aw_underflow(NLW_U0_axi_aw_underflow_UNCONNECTED),
        .axi_aw_wr_data_count(NLW_U0_axi_aw_wr_data_count_UNCONNECTED[4:0]),
        .axi_b_data_count(NLW_U0_axi_b_data_count_UNCONNECTED[4:0]),
        .axi_b_dbiterr(NLW_U0_axi_b_dbiterr_UNCONNECTED),
        .axi_b_injectdbiterr(1'b0),
        .axi_b_injectsbiterr(1'b0),
        .axi_b_overflow(NLW_U0_axi_b_overflow_UNCONNECTED),
        .axi_b_prog_empty(NLW_U0_axi_b_prog_empty_UNCONNECTED),
        .axi_b_prog_empty_thresh({1'b0,1'b0,1'b0,1'b0}),
        .axi_b_prog_full(NLW_U0_axi_b_prog_full_UNCONNECTED),
        .axi_b_prog_full_thresh({1'b0,1'b0,1'b0,1'b0}),
        .axi_b_rd_data_count(NLW_U0_axi_b_rd_data_count_UNCONNECTED[4:0]),
        .axi_b_sbiterr(NLW_U0_axi_b_sbiterr_UNCONNECTED),
        .axi_b_underflow(NLW_U0_axi_b_underflow_UNCONNECTED),
        .axi_b_wr_data_count(NLW_U0_axi_b_wr_data_count_UNCONNECTED[4:0]),
        .axi_r_data_count(NLW_U0_axi_r_data_count_UNCONNECTED[10:0]),
        .axi_r_dbiterr(NLW_U0_axi_r_dbiterr_UNCONNECTED),
        .axi_r_injectdbiterr(1'b0),
        .axi_r_injectsbiterr(1'b0),
        .axi_r_overflow(NLW_U0_axi_r_overflow_UNCONNECTED),
        .axi_r_prog_empty(NLW_U0_axi_r_prog_empty_UNCONNECTED),
        .axi_r_prog_empty_thresh({1'b0,1'b0,1'b0,1'b0,1'b0,1'b0,1'b0,1'b0,1'b0,1'b0}),
        .axi_r_prog_full(NLW_U0_axi_r_prog_full_UNCONNECTED),
        .axi_r_prog_full_thresh({1'b0,1'b0,1'b0,1'b0,1'b0,1'b0,1'b0,1'b0,1'b0,1'b0}),
        .axi_r_rd_data_count(NLW_U0_axi_r_rd_data_count_UNCONNECTED[10:0]),
        .axi_r_sbiterr(NLW_U0_axi_r_sbiterr_UNCONNECTED),
        .axi_r_underflow(NLW_U0_axi_r_underflow_UNCONNECTED),
        .axi_r_wr_data_count(NLW_U0_axi_r_wr_data_count_UNCONNECTED[10:0]),
        .axi_w_data_count(NLW_U0_axi_w_data_count_UNCONNECTED[10:0]),
        .axi_w_dbiterr(NLW_U0_axi_w_dbiterr_UNCONNECTED),
        .axi_w_injectdbiterr(1'b0),
        .axi_w_injectsbiterr(1'b0),
        .axi_w_overflow(NLW_U0_axi_w_overflow_UNCONNECTED),
        .axi_w_prog_empty(NLW_U0_axi_w_prog_empty_UNCONNECTED),
        .axi_w_prog_empty_thresh({1'b0,1'b0,1'b0,1'b0,1'b0,1'b0,1'b0,1'b0,1'b0,1'b0}),
        .axi_w_prog_full(NLW_U0_axi_w_prog_full_UNCONNECTED),
        .axi_w_prog_full_thresh({1'b0,1'b0,1'b0,1'b0,1'b0,1'b0,1'b0,1'b0,1'b0,1'b0}),
        .axi_w_rd_data_count(NLW_U0_axi_w_rd_data_count_UNCONNECTED[10:0]),
        .axi_w_sbiterr(NLW_U0_axi_w_sbiterr_UNCONNECTED),
        .axi_w_underflow(NLW_U0_axi_w_underflow_UNCONNECTED),
        .axi_w_wr_data_count(NLW_U0_axi_w_wr_data_count_UNCONNECTED[10:0]),
        .axis_data_count(NLW_U0_axis_data_count_UNCONNECTED[10:0]),
        .axis_dbiterr(NLW_U0_axis_dbiterr_UNCONNECTED),
        .axis_injectdbiterr(1'b0),
        .axis_injectsbiterr(1'b0),
        .axis_overflow(NLW_U0_axis_overflow_UNCONNECTED),
        .axis_prog_empty(NLW_U0_axis_prog_empty_UNCONNECTED),
        .axis_prog_empty_thresh({1'b0,1'b0,1'b0,1'b0,1'b0,1'b0,1'b0,1'b0,1'b0,1'b0}),
        .axis_prog_full(NLW_U0_axis_prog_full_UNCONNECTED),
        .axis_prog_full_thresh({1'b0,1'b0,1'b0,1'b0,1'b0,1'b0,1'b0,1'b0,1'b0,1'b0}),
        .axis_rd_data_count(NLW_U0_axis_rd_data_count_UNCONNECTED[10:0]),
        .axis_sbiterr(NLW_U0_axis_sbiterr_UNCONNECTED),
        .axis_underflow(NLW_U0_axis_underflow_UNCONNECTED),
        .axis_wr_data_count(NLW_U0_axis_wr_data_count_UNCONNECTED[10:0]),
        .backup(1'b0),
        .backup_marker(1'b0),
        .clk(clk),
        .data_count(NLW_U0_data_count_UNCONNECTED[10:0]),
        .dbiterr(NLW_U0_dbiterr_UNCONNECTED),
        .din(din),
        .dout(dout),
        .empty(empty),
        .full(full),
        .injectdbiterr(1'b0),
        .injectsbiterr(1'b0),
        .int_clk(1'b0),
        .m_aclk(1'b0),
        .m_aclk_en(1'b0),
        .m_axi_araddr(NLW_U0_m_axi_araddr_UNCONNECTED[31:0]),
        .m_axi_arburst(NLW_U0_m_axi_arburst_UNCONNECTED[1:0]),
        .m_axi_arcache(NLW_U0_m_axi_arcache_UNCONNECTED[3:0]),
        .m_axi_arid(NLW_U0_m_axi_arid_UNCONNECTED[0]),
        .m_axi_arlen(NLW_U0_m_axi_arlen_UNCONNECTED[7:0]),
        .m_axi_arlock(NLW_U0_m_axi_arlock_UNCONNECTED[0]),
        .m_axi_arprot(NLW_U0_m_axi_arprot_UNCONNECTED[2:0]),
        .m_axi_arqos(NLW_U0_m_axi_arqos_UNCONNECTED[3:0]),
        .m_axi_arready(1'b0),
        .m_axi_arregion(NLW_U0_m_axi_arregion_UNCONNECTED[3:0]),
        .m_axi_arsize(NLW_U0_m_axi_arsize_UNCONNECTED[2:0]),
        .m_axi_aruser(NLW_U0_m_axi_aruser_UNCONNECTED[0]),
        .m_axi_arvalid(NLW_U0_m_axi_arvalid_UNCONNECTED),
        .m_axi_awaddr(NLW_U0_m_axi_awaddr_UNCONNECTED[31:0]),
        .m_axi_awburst(NLW_U0_m_axi_awburst_UNCONNECTED[1:0]),
        .m_axi_awcache(NLW_U0_m_axi_awcache_UNCONNECTED[3:0]),
        .m_axi_awid(NLW_U0_m_axi_awid_UNCONNECTED[0]),
        .m_axi_awlen(NLW_U0_m_axi_awlen_UNCONNECTED[7:0]),
        .m_axi_awlock(NLW_U0_m_axi_awlock_UNCONNECTED[0]),
        .m_axi_awprot(NLW_U0_m_axi_awprot_UNCONNECTED[2:0]),
        .m_axi_awqos(NLW_U0_m_axi_awqos_UNCONNECTED[3:0]),
        .m_axi_awready(1'b0),
        .m_axi_awregion(NLW_U0_m_axi_awregion_UNCONNECTED[3:0]),
        .m_axi_awsize(NLW_U0_m_axi_awsize_UNCONNECTED[2:0]),
        .m_axi_awuser(NLW_U0_m_axi_awuser_UNCONNECTED[0]),
        .m_axi_awvalid(NLW_U0_m_axi_awvalid_UNCONNECTED),
        .m_axi_bid(1'b0),
        .m_axi_bready(NLW_U0_m_axi_bready_UNCONNECTED),
        .m_axi_bresp({1'b0,1'b0}),
        .m_axi_buser(1'b0),
        .m_axi_bvalid(1'b0),
        .m_axi_rdata({1'b0,1'b0,1'b0,1'b0,1'b0,1'b0,1'b0,1'b0,1'b0,1'b0,1'b0,1'b0,1'b0,1'b0,1'b0,1'b0,1'b0,1'b0,1'b0,1'b0,1'b0,1'b0,1'b0,1'b0,1'b0,1'b0,1'b0,1'b0,1'b0,1'b0,1'b0,1'b0,1'b0,1'b0,1'b0,1'b0,1'b0,1'b0,1'b0,1'b0,1'b0,1'b0,1'b0,1'b0,1'b0,1'b0,1'b0,1'b0,1'b0,1'b0,1'b0,1'b0,1'b0,1'b0,1'b0,1'b0,1'b0,1'b0,1'b0,1'b0,1'b0,1'b0,1'b0,1'b0}),
        .m_axi_rid(1'b0),
        .m_axi_rlast(1'b0),
        .m_axi_rready(NLW_U0_m_axi_rready_UNCONNECTED),
        .m_axi_rresp({1'b0,1'b0}),
        .m_axi_ruser(1'b0),
        .m_axi_rvalid(1'b0),
        .m_axi_wdata(NLW_U0_m_axi_wdata_UNCONNECTED[63:0]),
        .m_axi_wid(NLW_U0_m_axi_wid_UNCONNECTED[0]),
        .m_axi_wlast(NLW_U0_m_axi_wlast_UNCONNECTED),
        .m_axi_wready(1'b0),
        .m_axi_wstrb(NLW_U0_m_axi_wstrb_UNCONNECTED[7:0]),
        .m_axi_wuser(NLW_U0_m_axi_wuser_UNCONNECTED[0]),
        .m_axi_wvalid(NLW_U0_m_axi_wvalid_UNCONNECTED),
        .m_axis_tdata(NLW_U0_m_axis_tdata_UNCONNECTED[7:0]),
        .m_axis_tdest(NLW_U0_m_axis_tdest_UNCONNECTED[0]),
        .m_axis_tid(NLW_U0_m_axis_tid_UNCONNECTED[0]),
        .m_axis_tkeep(NLW_U0_m_axis_tkeep_UNCONNECTED[0]),
        .m_axis_tlast(NLW_U0_m_axis_tlast_UNCONNECTED),
        .m_axis_tready(1'b0),
        .m_axis_tstrb(NLW_U0_m_axis_tstrb_UNCONNECTED[0]),
        .m_axis_tuser(NLW_U0_m_axis_tuser_UNCONNECTED[3:0]),
        .m_axis_tvalid(NLW_U0_m_axis_tvalid_UNCONNECTED),
        .overflow(NLW_U0_overflow_UNCONNECTED),
        .prog_empty(NLW_U0_prog_empty_UNCONNECTED),
        .prog_empty_thresh({1'b0,1'b0,1'b0,1'b0,1'b0,1'b0,1'b0,1'b0,1'b0,1'b0,1'b0}),
        .prog_empty_thresh_assert({1'b0,1'b0,1'b0,1'b0,1'b0,1'b0,1'b0,1'b0,1'b0,1'b0,1'b0}),
        .prog_empty_thresh_negate({1'b0,1'b0,1'b0,1'b0,1'b0,1'b0,1'b0,1'b0,1'b0,1'b0,1'b0}),
        .prog_full(prog_full),
        .prog_full_thresh({1'b0,1'b0,1'b0,1'b0,1'b0,1'b0,1'b0,1'b0,1'b0,1'b0,1'b0}),
        .prog_full_thresh_assert({1'b0,1'b0,1'b0,1'b0,1'b0,1'b0,1'b0,1'b0,1'b0,1'b0,1'b0}),
        .prog_full_thresh_negate({1'b0,1'b0,1'b0,1'b0,1'b0,1'b0,1'b0,1'b0,1'b0,1'b0,1'b0}),
        .rd_clk(1'b0),
        .rd_data_count(NLW_U0_rd_data_count_UNCONNECTED[10:0]),
        .rd_en(rd_en),
        .rd_rst(1'b0),
        .rd_rst_busy(NLW_U0_rd_rst_busy_UNCONNECTED),
        .rst(1'b0),
        .s_aclk(1'b0),
        .s_aclk_en(1'b0),
        .s_aresetn(1'b0),
        .s_axi_araddr({1'b0,1'b0,1'b0,1'b0,1'b0,1'b0,1'b0,1'b0,1'b0,1'b0,1'b0,1'b0,1'b0,1'b0,1'b0,1'b0,1'b0,1'b0,1'b0,1'b0,1'b0,1'b0,1'b0,1'b0,1'b0,1'b0,1'b0,1'b0,1'b0,1'b0,1'b0,1'b0}),
        .s_axi_arburst({1'b0,1'b0}),
        .s_axi_arcache({1'b0,1'b0,1'b0,1'b0}),
        .s_axi_arid(1'b0),
        .s_axi_arlen({1'b0,1'b0,1'b0,1'b0,1'b0,1'b0,1'b0,1'b0}),
        .s_axi_arlock(1'b0),
        .s_axi_arprot({1'b0,1'b0,1'b0}),
        .s_axi_arqos({1'b0,1'b0,1'b0,1'b0}),
        .s_axi_arready(NLW_U0_s_axi_arready_UNCONNECTED),
        .s_axi_arregion({1'b0,1'b0,1'b0,1'b0}),
        .s_axi_arsize({1'b0,1'b0,1'b0}),
        .s_axi_aruser(1'b0),
        .s_axi_arvalid(1'b0),
        .s_axi_awaddr({1'b0,1'b0,1'b0,1'b0,1'b0,1'b0,1'b0,1'b0,1'b0,1'b0,1'b0,1'b0,1'b0,1'b0,1'b0,1'b0,1'b0,1'b0,1'b0,1'b0,1'b0,1'b0,1'b0,1'b0,1'b0,1'b0,1'b0,1'b0,1'b0,1'b0,1'b0,1'b0}),
        .s_axi_awburst({1'b0,1'b0}),
        .s_axi_awcache({1'b0,1'b0,1'b0,1'b0}),
        .s_axi_awid(1'b0),
        .s_axi_awlen({1'b0,1'b0,1'b0,1'b0,1'b0,1'b0,1'b0,1'b0}),
        .s_axi_awlock(1'b0),
        .s_axi_awprot({1'b0,1'b0,1'b0}),
        .s_axi_awqos({1'b0,1'b0,1'b0,1'b0}),
        .s_axi_awready(NLW_U0_s_axi_awready_UNCONNECTED),
        .s_axi_awregion({1'b0,1'b0,1'b0,1'b0}),
        .s_axi_awsize({1'b0,1'b0,1'b0}),
        .s_axi_awuser(1'b0),
        .s_axi_awvalid(1'b0),
        .s_axi_bid(NLW_U0_s_axi_bid_UNCONNECTED[0]),
        .s_axi_bready(1'b0),
        .s_axi_bresp(NLW_U0_s_axi_bresp_UNCONNECTED[1:0]),
        .s_axi_buser(NLW_U0_s_axi_buser_UNCONNECTED[0]),
        .s_axi_bvalid(NLW_U0_s_axi_bvalid_UNCONNECTED),
        .s_axi_rdata(NLW_U0_s_axi_rdata_UNCONNECTED[63:0]),
        .s_axi_rid(NLW_U0_s_axi_rid_UNCONNECTED[0]),
        .s_axi_rlast(NLW_U0_s_axi_rlast_UNCONNECTED),
        .s_axi_rready(1'b0),
        .s_axi_rresp(NLW_U0_s_axi_rresp_UNCONNECTED[1:0]),
        .s_axi_ruser(NLW_U0_s_axi_ruser_UNCONNECTED[0]),
        .s_axi_rvalid(NLW_U0_s_axi_rvalid_UNCONNECTED),
        .s_axi_wdata({1'b0,1'b0,1'b0,1'b0,1'b0,1'b0,1'b0,1'b0,1'b0,1'b0,1'b0,1'b0,1'b0,1'b0,1'b0,1'b0,1'b0,1'b0,1'b0,1'b0,1'b0,1'b0,1'b0,1'b0,1'b0,1'b0,1'b0,1'b0,1'b0,1'b0,1'b0,1'b0,1'b0,1'b0,1'b0,1'b0,1'b0,1'b0,1'b0,1'b0,1'b0,1'b0,1'b0,1'b0,1'b0,1'b0,1'b0,1'b0,1'b0,1'b0,1'b0,1'b0,1'b0,1'b0,1'b0,1'b0,1'b0,1'b0,1'b0,1'b0,1'b0,1'b0,1'b0,1'b0}),
        .s_axi_wid(1'b0),
        .s_axi_wlast(1'b0),
        .s_axi_wready(NLW_U0_s_axi_wready_UNCONNECTED),
        .s_axi_wstrb({1'b0,1'b0,1'b0,1'b0,1'b0,1'b0,1'b0,1'b0}),
        .s_axi_wuser(1'b0),
        .s_axi_wvalid(1'b0),
        .s_axis_tdata({1'b0,1'b0,1'b0,1'b0,1'b0,1'b0,1'b0,1'b0}),
        .s_axis_tdest(1'b0),
        .s_axis_tid(1'b0),
        .s_axis_tkeep(1'b0),
        .s_axis_tlast(1'b0),
        .s_axis_tready(NLW_U0_s_axis_tready_UNCONNECTED),
        .s_axis_tstrb(1'b0),
        .s_axis_tuser({1'b0,1'b0,1'b0,1'b0}),
        .s_axis_tvalid(1'b0),
        .sbiterr(NLW_U0_sbiterr_UNCONNECTED),
        .sleep(1'b0),
        .srst(srst),
        .underflow(NLW_U0_underflow_UNCONNECTED),
        .valid(valid),
        .wr_ack(NLW_U0_wr_ack_UNCONNECTED),
        .wr_clk(1'b0),
        .wr_data_count(NLW_U0_wr_data_count_UNCONNECTED[10:0]),
        .wr_en(wr_en),
        .wr_rst(1'b0),
        .wr_rst_busy(NLW_U0_wr_rst_busy_UNCONNECTED));
endmodule
`pragma protect begin_protected
`pragma protect version = 1
`pragma protect encrypt_agent = "XILINX"
`pragma protect encrypt_agent_info = "Xilinx Encryption Tool 2025.1"
`pragma protect key_keyowner="Synopsys", key_keyname="SNPS-VCS-RSA-2", key_method="rsa"
`pragma protect encoding = (enctype="BASE64", line_length=76, bytes=128)
`pragma protect key_block
gydSV72FvW4hnoyUt6yZFJHfJqjRQWPUfYIuDKP0fpjrPOkLRbJGBr4Z9msYTvoIHRlYtXJ2YMY0
d1TIQb+FK4gKsTRru9wr397OxuFBsTRf4e+ZjpYZEdsnqYWcgMSzhN4yhPvO06GyZO15y/LKBxa8
3OKwxVlOLYXhv+sxdXg=

`pragma protect key_keyowner="Aldec", key_keyname="ALDEC15_001", key_method="rsa"
`pragma protect encoding = (enctype="BASE64", line_length=76, bytes=256)
`pragma protect key_block
WHB6Zbfa5Qi47krP9T4L8UnPOlr881dWx7UcYaZfNGIQQM0gadcoXbhucIpRaUuyOKxv6yhKveRN
h0l+N9+KX6rbZ6+TRhP9JAMuPhlpI7T42QtRv5zx9+m3ct5S0NMszbFaK8zeTAYra5BGP7BHmtkr
MpKfLK5sFyaTE/A7ACtAace9MwFTHDZdl9uUs4aY6KJlm6GaypKduiqkNugukJp5vlFPX/ZapJqG
KMtMhI6grhcuYb1FJrwRZ4jW7hs9HxddSdGLzsZ0HsBcO/qaCPTst+ZA0YIQfd5ULlFmPqq39FfO
p1P+2hEH2n+LycbMj5cn4Dxfqv2R8eucM78R3w==

`pragma protect key_keyowner="Mentor Graphics Corporation", key_keyname="MGC-VELOCE-RSA", key_method="rsa"
`pragma protect encoding = (enctype="BASE64", line_length=76, bytes=128)
`pragma protect key_block
SmAzQA1VEuJXtJi5vXa2Jg7YvRqAJs6PX9HTZ1YqrJw4VfonBW3726gJ81BjlizpMkcf/Uk5sFIK
aPedVhEs4xCIZylz7gXYDshtytOA/pXUID2qV9nXr8qfI+FydSADUF3ScYDZmlkclFqlZrGq6DQ7
da3lJAzt2h/iR+cczrA=

`pragma protect key_keyowner="Mentor Graphics Corporation", key_keyname="MGC-VERIF-SIM-RSA-2", key_method="rsa"
`pragma protect encoding = (enctype="BASE64", line_length=76, bytes=256)
`pragma protect key_block
iAph5JWb/chMQpLPX1UoLjQDxN5l2I8McM/k2xN5wRht7HXoE6F5yV8luDjn3zkI6vnfUYo7BaI1
mogRRx+R3XcwxvhHr+lngh4+/YLVex1TFncl+kiUMAsu3M/FjFSiqGMVMdKTNLDqr35DuZJVyuiF
lTwXob/KkbQDJiJjBEoxbt+968rKRKRyJGcqIjm4mqRBdqMcgo3HOJFG74SFsWAQrxvXfBhdLSG3
OfoLfls9XDojBjp7G83k0h82g1eeWgBfydm/OcX9o48Pst93NvI4ua8WShZL8MCvRWYqWZrrjrWi
cfUjXAF5SDACjq1/OU6arz/Idz6/a7AP/jmexw==

`pragma protect key_keyowner="Real Intent", key_keyname="RI-RSA-KEY-1", key_method="rsa"
`pragma protect encoding = (enctype="BASE64", line_length=76, bytes=256)
`pragma protect key_block
BY49GZBxBT/gjZDPyaSWlti/sctckoR7jK6NuWdhnF9tiyNfVU7BqjjwxSnyMi0Uucv1BKHXC18h
8hQbFWnNtrq71ilURotXux7sssHlVJ2i1CsJWU18DOcBWxm2ai89uwvxDJh3TJkBJixB5KPvsDhL
lWOjTvZWPoR+Ixy+Tzo+U5Vx7z7SOakRwTrn3u7+c3vmCEBphE+HKeJExhBAoOEd0SXK5iwXaByW
D7Wb7zq6NNUmnCyaJ2BG9kGxLVsf+md7SlocuaFsYyaRZhwPyTucxIlz1tLYwcytKzx0ovoax3no
nYgzlzP/F0/PDWk9BqXgr/tuclc4EZYX0cf4ng==

`pragma protect key_keyowner="Xilinx", key_keyname="xilinxt_2025.1-2029.x", key_method="rsa"
`pragma protect encoding = (enctype="BASE64", line_length=76, bytes=256)
`pragma protect key_block
qGnCvL35qO7cbUEKCL50yDv1UvezcqBz601zctKop1954QlcjemzZWZHg1zJ00nJaToNdH2S8AKX
n8hNJvbQ+x5HEGL5DoSU9m5qjXd8xxocnZ0yzuZX/dGCT8kDn3gWJR2Gz13pT+w2LQUno1fX+MsC
ehgwvjBBT6GeYjdxHi+aybQUP9AblSxX/z3vh857SGCPohEWvghOgORCHAe45YD+ZWnL62FLxMM2
c+Ozq/Au/Q4q1Yzlzcfv8Mnsvg7OqOeEamQHbuYOfdkJUuYqOwsskEWW348u7FXtsf8m7P3pZyyz
IWyTDAW4igGguMPLHfbtK/twZx8ScJQmOKzglg==

`pragma protect key_keyowner="Metrics Technologies Inc.", key_keyname="DSim", key_method="rsa"
`pragma protect encoding = (enctype="BASE64", line_length=76, bytes=256)
`pragma protect key_block
Hz+6K8+wh5/fukU4ZWNDXGsq6hreSVCSPP67nA6kUz9Vpjy4TtTnOrrl1BWY0ivEC7Ldyw8VI60A
VO/WPlt409LdAZdMZGsEZ1JuTZ0m9LPcgu9CPCyoMECctmd8LHE+otY6etTmYABB9syY61rk2hrv
RgbcyT/HCK9TzWxSm+XMqvx2nvagCLkMDPh/JZv51fj2zcKaBPnxsz8rnDipaeo0fEyVRC3Y1F/V
U3RmXojBjIumPHSJkQ537dENJEIA0Ra65u8EM/+ItUn1bcryLcIbKy1xGadrHmHdHRUoRcAodO2C
B48bNVeL0VnGg8P9ACIB04lMNzn5p6A1tPOb4Q==

`pragma protect key_keyowner="Atrenta", key_keyname="ATR-SG-RSA-1", key_method="rsa"
`pragma protect encoding = (enctype="BASE64", line_length=76, bytes=384)
`pragma protect key_block
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

`pragma protect key_keyowner="Cadence Design Systems.", key_keyname="CDS_RSA_KEY_VER_1", key_method="rsa"
`pragma protect encoding = (enctype="BASE64", line_length=76, bytes=256)
`pragma protect key_block
Q+63zFEYw/LeMgxa7g8g79GGvSyIKDKD8RvvC4DHDQuGObf6n9OGZX4e17v/E/+EDEwUhsWQHFDI
Lp/aH+6fNRmhu9BEWVjxq2WRrQSl4eQjfIaSOXu2dlYh3JjRJwiUp4LteVh8RFAf5t5sRQO4dRIK
x+h28yliSgibaWEAv5FaJQ1EFbNwmgedAaSYjgf2A3afBUcBh5Uy9VHbW/zRzdhhJdsVNBjZYcFy
CVLOcf1toCRp8J4U5FlnFMOzFegUbdXFQhq2VmIhPRxWjrfTk6iR4BcMEN9UMij/5IHRAeBdksyD
CqEKsyFxosbI5KVMRZ1Ln75Zipn0JdsGekHkxg==

`pragma protect key_keyowner="Synplicity", key_keyname="SYNP15_1", key_method="rsa"
`pragma protect encoding = (enctype="BASE64", line_length=76, bytes=256)
`pragma protect key_block
DPUa5DLPYRWvbPnX0U412yoWvvvHyuq43DrYmDJGTK0cR5U4U6th8icYgizC1/hUAEzt19kM/hVa
zZh7bXSWACYLpcfhPY8dRTVGDZVjpbkraw0ceBryLP7jc6Jt5JdNw88tZtZpprCB7nQ25lUL82Hf
WTwL1ZqgGIvtfHhxO0JF5L5ES5giedwQ6u5ffXG3UB6ELcpQD1NvpW5lAz4mfXyvVDCAPZN581TF
tlAy79iKbPKlJ2zFn1BS2cuRIHHe2JRxwPo+0n5VD5CXVgg+lCYxTnCxI8CdyFaTumbs4IfAKwVI
wSN/btbwDUhW9hAHWHIRo+BpdJ4qeGcTDPKtsA==

`pragma protect key_keyowner="Mentor Graphics Corporation", key_keyname="MGC-PREC-RSA", key_method="rsa"
`pragma protect encoding = (enctype="BASE64", line_length=76, bytes=256)
`pragma protect key_block
mf5hcf6JE6yLm0jNCQnHMVmogjLlPz6re0FwG67yvOJ3FuEorru0emIeAKEwgOoxjUYNWvcM7QAH
/UEeB2EIdjLl6glPAUda0HjtaCU2rdncVdM8k6DSMBggc4yo18Qx5F+1TD/RoBgoo0jNkMdDy6wJ
JHjqlN+R01z3yYIMQ9f2z6ZaYncbBYEp4+YAb7g1D7CSMxP5cFRpQznRpYp0JwqJfT9CHzlKgdab
8B288NxeLM66iYodiTS+GSRGLGtDWXpz9yeiuiPe6kJxae2GJyHIMSfluO/0Slc3m24DQNdbojf8
jdc0G2UnrDe5mCUTfYiDmpOWTUJOdYo0FK0N2g==

`pragma protect data_method = "AES128-CBC"
`pragma protect encoding = (enctype = "BASE64", line_length = 76, bytes = 108320)
`pragma protect data_block
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
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
