Killerbee12/TFM-UPM/Practica/Prueba1_demo_v2.1.1/Prueba1_demo_v2.1.1.gen/sources_1/bd/design_1/ip/design_1_util_vector_logic_0_0/design_1_util_vector_logic_0_0_stub.v

// Copyright 1986-2022 Xilinx, Inc. All Rights Reserved.
// Copyright 2022-2025 Advanced Micro Devices, Inc. All Rights Reserved.
// --------------------------------------------------------------------------------
// Tool Version: Vivado v.2025.1 (win64) Build 6140274 Thu May 22 00:12:29 MDT 2025
// Date        : Wed Aug  5 18:30:12 2026
// Host        : Samsung_Book_3 running 64-bit major release  (build 9200)
// Command     : write_verilog -force -mode synth_stub
//               c:/Users/kille/Documents/GitHub/TFM-UPM/Practica/Prueba1_demo_v1.0/prueba1_demo.srcs/sources_1/bd/design_1/ip/design_1_util_vector_logic_0_0/design_1_util_vector_logic_0_0_stub.v
// Design      : design_1_util_vector_logic_0_0
// Purpose     : Stub declaration of top-level module interface
// Device      : xc7a100tcsg324-1
// --------------------------------------------------------------------------------

// This empty module with port declaration file causes synthesis tools to infer a black box for IP.
// The synthesis directives are for Synopsys Synplify support to prevent IO buffer insertion.
// Please paste the declaration into a Verilog source file or add the file as an additional source.
(* CHECK_LICENSE_TYPE = "design_1_util_vector_logic_0_0,util_vector_logic_v2_0_5_util_vector_logic,{}" *) (* CORE_GENERATION_INFO = "design_1_util_vector_logic_0_0,util_vector_logic_v2_0_5_util_vector_logic,{x_ipProduct=Vivado 2025.1,x_ipVendor=xilinx.com,x_ipLibrary=ip,x_ipName=util_vector_logic,x_ipVersion=2.0,x_ipCoreRevision=5,x_ipLanguage=VHDL,x_ipSimLanguage=MIXED,C_OPERATION=not,C_SIZE=8}" *) (* DowngradeIPIdentifiedWarnings = "yes" *) 
(* X_CORE_INFO = "util_vector_logic_v2_0_5_util_vector_logic,Vivado 2025.1" *) 
module design_1_util_vector_logic_0_0(Op1, Res)
/* synthesis syn_black_box black_box_pad_pin="Op1[7:0],Res[7:0]" */;
  input [7:0]Op1;
  output [7:0]Res;
endmodule
