Killerbee12/TFM-UPM/Practica/Prueba1/prueba_v1.0.gen/sources_1/bd/design_1/ip/design_1_system_ila_0_0/bd_0/sim/bd_f60c.vhd

--Copyright 1986-2022 Xilinx, Inc. All Rights Reserved.
--Copyright 2022-2025 Advanced Micro Devices, Inc. All Rights Reserved.
----------------------------------------------------------------------------------
--Command: generate_target bd_f60c.bd
--Design : bd_f60c
--Purpose: IP block netlist
----------------------------------------------------------------------------------
library IEEE;
use IEEE.STD_LOGIC_1164.ALL;
library UNISIM;
use UNISIM.VCOMPONENTS.ALL;
entity bd_f60c is
  port (
    clk : in STD_LOGIC;
    probe0 : in STD_LOGIC_VECTOR ( 0 to 0 )
  );
  attribute CORE_GENERATION_INFO : string;
  attribute CORE_GENERATION_INFO of bd_f60c : entity is "bd_f60c,IP_Integrator,{x_ipVendor=xilinx.com,x_ipLibrary=BlockDiagram,x_ipName=bd_f60c,x_ipVersion=1.00.a,x_ipLanguage=VHDL,numBlks=1,numReposBlks=1,numNonXlnxBlks=0,numHierBlks=0,maxHierDepth=0,numSysgenBlks=0,numHlsBlks=0,numHdlrefBlks=0,numPkgbdBlks=0,bdsource=SBD,synth_mode=None}";
  attribute HW_HANDOFF : string;
  attribute HW_HANDOFF of bd_f60c : entity is "design_1_system_ila_0_0.hwdef";
end bd_f60c;

architecture STRUCTURE of bd_f60c is
  component bd_f60c_ila_lib_0 is
  port (
    clk : in STD_LOGIC;
    probe0 : in STD_LOGIC_VECTOR ( 0 to 0 )
  );
  end component bd_f60c_ila_lib_0;
  attribute X_INTERFACE_INFO : string;
  attribute X_INTERFACE_INFO of clk : signal is "xilinx.com:signal:clock:1.0 CLK.CLK CLK";
  attribute X_INTERFACE_PARAMETER : string;
  attribute X_INTERFACE_PARAMETER of clk : signal is "XIL_INTERFACENAME CLK.CLK, CLK_DOMAIN bd_f60c_clk, FREQ_HZ 100000000, FREQ_TOLERANCE_HZ 0, INSERT_VIP 0, PHASE 0.0";
begin
ila_lib: component bd_f60c_ila_lib_0
     port map (
      clk => clk,
      probe0(0) => probe0(0)
    );
end STRUCTURE;
