Killerbee12/TFM-UPM/(commit log)

2026-06-16 Actualizacion de documentacion
2026-06-30 Prueba Leds v1.0
    [waveform.csv]
2026-07-01 Updated ...
    [waveform.csv]
2026-07-06 Update Pdf leds
2026-07-24 Updated fase 1 y 2 funcionando
    [waveform.csv]
2026-07-30 Update fases 1,2 y 3 terminadas
    [waveform.csv]
2026-08-31 Update v1.1 prueba con aumento de FIFO y variable de habilitacion hasta configurar i2c
2026-09-01 Preparacion de prueba 2
2026-09-04 Version final de la demo v2.0
2026-09-04 Proyecto runeando la ultima version de la demo 2.0
